arizzoni/baseboard/README.md

# baseboard
hardware audio effects I/O baseboard
