arizzoni/baseboard/doc/drd.pdf

Baseboard

Design Reference Document

(None) (None)

(None)

1

Contents

Revision History

4
1 Introduction

6
2 Specifications

6
3 System Architecture

6
4 Power Supplies

6
4.1 Overview

6
4.2 Analog Supply

7
4.2.1 Inductor

7
4.2.2 Feedback Network

8
4.2.3 Diode

. 10
4.2.4 Input/Output Capacitors

. 10
4.2.5 SEPIC Coupling Capacitor

. 10
4.2.6 Compensation Network

. 10
4.2.7 Linear Regulator

. 10
4.3 Low-Voltage Supply

. 11
4.3.1 Linear Regulator

. 11
5 Effects Interface

. 12
5.1 Switching

. 12
5.2 Interface

. 13
6 Microcontroller

. 13
6.0.1 Power

. 14
6.1 Memory

. 14
6.2 Clocks and Timing

. 14
6.3 GPIO

. 14
7 Peripherals

. 14
7.1 Overview

. 14
7.2 Footswitches

. 14
7.3 USB

. 14

Baseboard Design Reference Document | CONTENTS

This page intentionally left blank.

(None) | 3

Baseboard Design Reference Document | Revision History

Revision History

Version 1

Baseboard Design Reference Document | Revision History

This page intentionally left blank.

Baseboard Design Reference Document | Introduction

1 Introduction

The baseboard module contains all the signal and power IO for the effects pedal. Input voltage of 9V DC is regulated to 12V to drive an analog switch and the effects board and to 3.3V to drive the LED indicators and footswitches. A 16 bit microcontroller manages the switching logic, interfaces with peripherals, and supervises the power supply circuit. The audio input and output are routed to the effects modules via the switching circuitry through a cable.

2 Specifications

1. Power
(a) The Baseboard shall provide a 9–12V ±1% power supply capable of sourcing ±50 mA each to the audio effect modules
(b) The Baseboard shall provide low-voltage power circuitry capable of operation from 1.1V ±1% to 3.3V ±1%
(c) The Baseboard shall be capable of sourcing 300 mA peak to drive local peripherals
2. Input/Output
(a) The Baseboard shall route the audio signal to the baseboard while providing a true bypass path directly to the output
(b) The Baseboard shall provide input impedance of 1 MΩ ±1% and output impedance of 50 kΩ ±1%
(c) Input Filter
(d) Output Filter
3. Switching
(a) The audio signal shall be switched using high quality analog switches to maximize durability and signal integrity
(b) The switches shall have an input impedance of no greater than 500 Ω to minimize signal degradation

3 System Architecture

4 Power Supplies

4.1 Overview

Input power is provided from the DC input jack or the USB-C port and is fused with PTC thermistors. A full-bridge rectifier at the DC input jack allows for both center-negative and center-positive connections. Both supplies can be powered by either the DC input at 9–12V or the 5V USB VBUS supply, with current OR-ing capability provided by the polarity protection rectifier and a schottky diode in series with the USB VBUS. Following the current OR-ing circuitry and overcurrent protection, the input power flows to the DC/DC converters.
The Baseboard requires two voltage rails: the analog voltage rail at 12Vand the digital voltage rail at 3.3V. The analog voltage rail is powered by the Texas Instruments TPS61170 and the digital rail is powered using a voltage regulator for simplicity. The coupled-inductor SEPIC topology was selected for its low ripple and for its ability to act as both a step-up and step-down converter. The TPS61170 supports the SEPIC topology and has a high, fixed switching frequency of 1.2 MHz, allowing for small surface-mount passives to reduce cost and simplify assembly. The analog supply, at 12V, also employs a linear regulator as a filter to further reduce ripple and improve line regulation. The second regulator stage brings the voltage down to the 12V required to power the analog rail.

Baseboard Design Reference Document | 4.2 Analog Supply

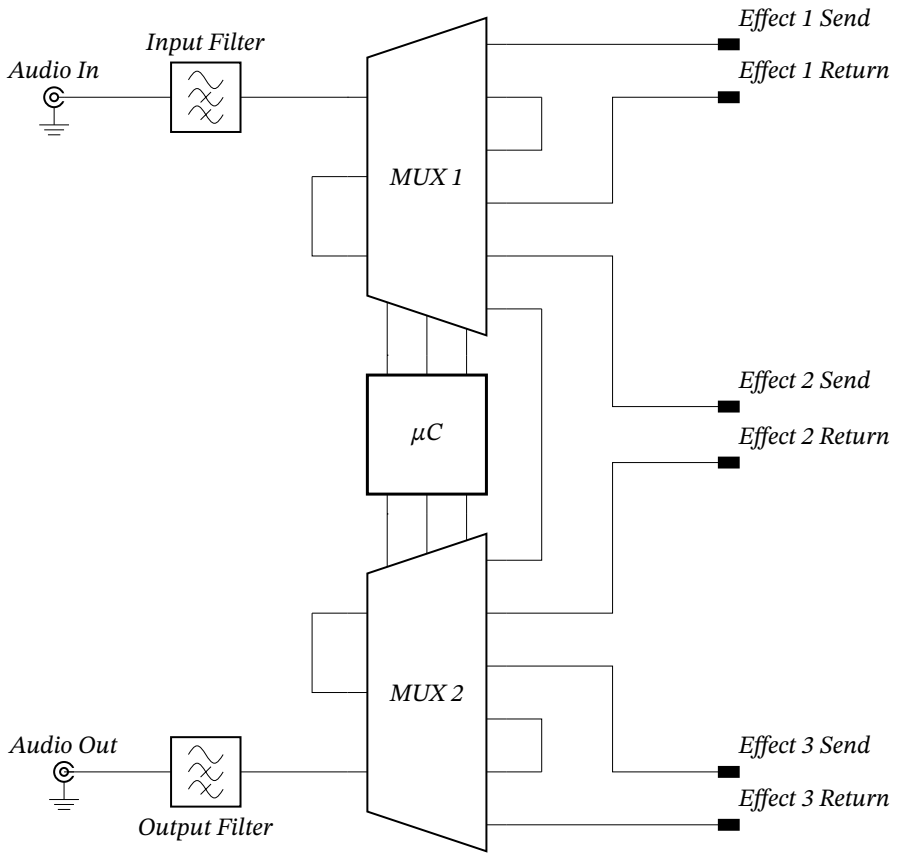
[picture p1: figure]
Audio In; Input Filter; MUX 1; Effect 1 Send; Effect 1 Return; Effect 2 Send; MUX 2; Effect 2 Return; Effect 3 Return; Effect 3 Send; Output Filter; Audio Out

Figure 1: Audio Switching Architecture

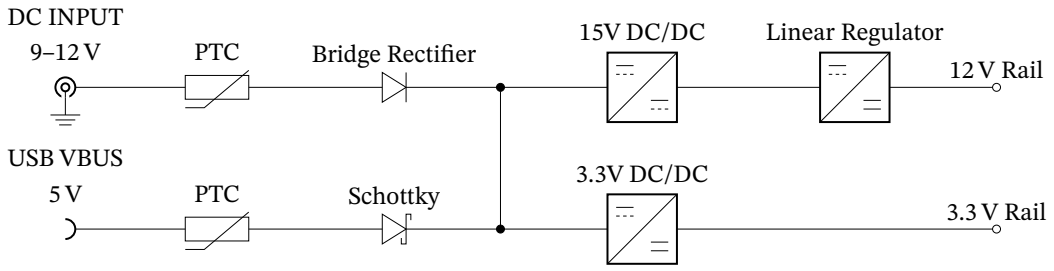
[picture p2: figure]
DC INPUT; PTC; Bridge Rectifier; Linear Regulator; 12V Rail; 3.3V Rail; USB VBUS; Schottky

Figure 2: Power Supply Architecture

4.2 Analog Supply

4.2.1 Inductor

The design for the analog DC/DC converter begins with inductor selection. Output current capacity is largely determined by the inductor size. For this design, a small inductor is sufficient as the amount of current required by the effects is generally small. A standard compact coupled inductor with series inductance of 22 µH and parallel inductance of 11 µH is predicted to be sufficient to drive loads at up to 80 mA per effects module, worst-case, by the following Monte Carlo analysis with parameters extracted from the relevant component’s datasheets

Baseboard Design Reference Document | 4.2 Analog Supply

and with three modules. The analysis was performed for the three specified input voltages: 5V, 9V, and 12V. Based on the analysis, the supply is able to safely drive 200 mA per effects module if powered from a 12V input, which allows for future expansion using this design.

300 mA | 350 mA | 400 mA | 450 mA | 500 mA

0

1000

2000 | Iout(Vin = 5V)
500 mA | 600 mA | 700 mA | 800 mA | 900 mA

0

1000

2000
Count (1)

Iout(Vin = 9V)

800 mA | 900 mA | 1 A | 1.1 A | 1.2 A | 1.3 A
Output Current (A)

0

1000

2000 | Iout(Vin12V)
300 mA | 350 mA | 400 mA | 450 mA | 500 mA

0.0

0.5

1.0
Iout(Vin = 5V)
500 mA | 600 mA | 700 mA | 800 mA | 900 mA

0.0

0.5

1.0
P (Iout ≤ Iout0

)
Iout(Vin = 9V)
800 mA | 900 mA | 1 A | 1.1 A | 1.2 A | 1.3 A
Output Current (A)

0.0

0.5

1.0
Iout(Vin12V)

Figure 3: Power Supply Maximum Output Current

The analysis begins by assuming each parameter may be described by a probability distribution function and assigning a reasonable function to each. For the majority of datasheet parameters, the manufacturer only provides three values: an upper bound, a lower bound, and a nominal value - we assume that these datasheet parameters have a triangular PDF based on the given bounds and value for the purpose of this analysis but this may very well not be the case depending on the available components.

4.2.2 Feedback Network

The output voltage of the converter is determined by the following expression.

Voᵆt = Vref (

R1
R2

+ 1)

Baseboard Design Reference Document | 4.2 Analog Supply

The output voltage is a function of R1 and R2

, and their tolerances determine the precision of the output voltage. The minimum possible output voltage, assuming all parts are within specifications, is 13.2V, so the values shall be chosen to yield an output above that so that 14V is beyond the lower tail of the output distribution. The value for Vref comes from the datasheet and is the internal feedback reference voltage of the TPS61170. The values chosen for the feedback resistors are below; a 1% tolerance was chosen as the standard design tolerance to reduce variation.

R1 = 86.6 kΩ ± 1%

R2 = 10.0 kΩ ± 1%

Voᵆt, min. ≈ 11.6V

11.7V | 11.8V | 11.9V | 12V | 12.1V
Output Voltage (V)

0

500

1000

1500

2000

Count (1)

11.7V | 11.8V | 11.9V | 12V | 12.1V
Output Voltage (V)

0.0

0.2

0.4

0.6

0.8

1.0

P (Vout ≤ Vout0

)

Figure 4: Power Supply Output Voltage

Baseboard Design Reference Document | 4.2 Analog Supply

4.2.3 Diode

The switching diode used must have a fast recovery time and support a larger reverse-voltage than that of the TPS61170 (40V). A robust component for this application is the Diodes Incorporated DFLS240L-7 in a PowerDI-123 package, which meets the requirements, has a low forward-voltage of around 20 mV at low currents, and is a standard part with many alternates available. The Diodes Incorporated DFLS260L-7, also in a PowerDI-123 package, is promoted as a robust alternate from the same family with a higher voltage rating.

ID = IS (e

qe−VD
nkBT − 1)

VD =

nkBT
qe⁻

ln (

ID
IS

+ 1)

4.2.4 Input/Output Capacitors

Input and output capacitors are selected based on the upper limits of the datasheet recommendations and are chosen to be 12 µF MLCC-type surface-mount capacitors. In order to minimize derating, a medium-voltage and physically large capacitor is selected with a voltage rating of greater than 50V.

Coᵆt,min. = 26.7 µF

4.2.5 SEPIC Coupling Capacitor

The SEPIC coupling capacitor is chosen to be 1 µF. Similar to the output capacitors, to minimize derating due to applied DC bias voltage, a medium-voltage and physically large capacitor is selected with a voltage rating of greater than 50V. The figure below suggests that a 500 nF capacitor would be sufficient, but the datasheet recommends 1 µF and there are already other 1 µF capacitors used in the design.

Cs,min. = 0.536 µF

4.2.6 Compensation Network

The compensation network for the DC/DC converter shall be tuned with the first prototypes.

4.2.7 Linear Regulator

The generic 1117-style three-terminal regulator was chosen as the post-regulator for the analog voltage rail for its low dropout voltage, low cost, and wide availability and compatibility with offerings from several manufacturers. The BOM specifies an Onsemi part number but any 1 A 1117-style regulator should be compatible.
The output voltage is determined via the typical three-terminal voltage regulator equation, shown below.

Voᵆt = Vref (1 +

R2
R1

) + IadjR2

Setting R1 = 120 Ω sets the current through the feedback network to 10 mA, which is nominally twice the required current to maintain regulation. With R1 defined, the other parameters are determined from the datasheet and a value for R2

is obtained.

Baseboard Design Reference Document | 4.3 Low-Voltage Supply
12 µF | 14 µF | 16 µF | 18 µF | 20 µF | 22 µF | 24 µF | 26 µF | 28 µF

0

5000

Cout(Vin = 5V)

10 µF | 12 µF | 14 µF | 16 µF | 18 µF | 20 µF

0

5000

Count (1)

Cout(Vin = 9V)

0 F | 200 nF | 400 nF | 600 nF | 800 nF
| | Output Capacitor Size (F)

0

250

500 | Cout(Vin12V)
12 µF | 14 µF | 16 µF | 18 µF | 20 µF | 22 µF | 24 µF | 26 µF | 28 µF

0.0

0.5

1.0
Cout(Vin = 5V)
10 µF | 12 µF | 14 µF | 16 µF | 18 µF | 20 µF

0.0

0.5

1.0

P (Cout ≤ Cout0

)

Cout(Vin = 9V)

0 F | 200 nF | 400 nF | 600 nF | 800 nF
| | Output Capacitor Size (F)

0.0

0.5

1.0
Cout(Vin12V)

Figure 5: Power Supply Output Capacitor Size

4.3 Low-Voltage Supply

4.3.1 Linear Regulator

The low voltage supply is provided by a linear voltage regulator for simplicity. In the future, a second switching converter may be designed to replace it, in the interest of efficiency. To consolidate the bill of materials the same regulator is used as for the analog supply. The output voltage is determined by the same relationship as that shown above. By letting Voᵆt = 3.3V, R1 = 120 Ω, and Iadj = 120 µA, the above relationship yields approximately R2 = 196 Ω. The low-voltage supply can be run at lower voltages. A study should be performed to determine how low - 1.8V is supported by all digital circuits in the system.

Baseboard Design Reference Document | Effects Interface
250 nF | 300 nF | 350 nF | 400 nF | 450 nF | 500 nF | 550 nF

0

5000

Cs

(Vin = 5V )

100 nF | 120 nF | 140 nF | 160 nF | 180 nF | 200 nF | 220 nF | 240 nF

0

5000

Count (1)

Cs

(Vin = 9V )

0 F | 1 nF | 2 nF | 3 nF | 4 nF | 5 nF | 6 nF | 7 nF
Coupling Capacitor Size (F)

0

250

500 | Cs

(Vin = 12V )

250 nF | 300 nF | 350 nF | 400 nF | 450 nF | 500 nF | 550 nF

0.0

0.5

1.0
Cs

(Vin = 5V )

100 nF | 120 nF | 140 nF | 160 nF | 180 nF | 200 nF | 220 nF | 240 nF

0.0

0.5

1.0
P (Cs ≤ Cs0

)
Cs

(Vin = 9V )

0 F | 1 nF | 2 nF | 3 nF | 4 nF | 5 nF | 6 nF | 7 nF
Coupling Capacitor Size (F)

0.0

0.5

1.0
Cs

(Vin = 12V )

Figure 6: Power Supply SEPIC Coupling Capacitor Size

5 Effects Interface

The effects interface connects three external effects modules through two TMUX4053 analog multiplexers. The TMUX4053 is an upgraded version of the standard 4053 CMOS multiplexer with a higher voltage rating and im-proved impedance parameters. The signals are sent to the external modules and return via the same connectors, then are routed through the multiplexer circuit to the next effects module or to the main output.

5.1 Switching

The TMUX4053 was selected for two main reasons. Primarily, it supports the 12V supply with comfortable mar-gin. As a second reason, the TMUX4053 is offered in a compact SMD package which improves reliability. The control signals for the multiplexers are generated by the RP2040 microcontroller which polls the footswitches and accordingly manages the switching logic for the multiplexers.

Baseboard Design Reference Document | 5.2 Interface
11.7V | 11.8V | 11.9V | 12V | 12.1V
Post-Regulator Output Voltage

0

500

1000

1500

2000

2500

Count (1)

Figure 7: Analog Supply Post-Regulator Output Voltage

3.24V | 3.26V | 3.28V | 3.3V | 3.32V
Digital Supply Output Voltage

0

500

1000

1500

2000

Count (1)

Vout = 12Vnom.

Figure 8: 3.3V Regulator Output Voltage

5.2 Interface

6 Microcontroller

The Raspberry Pi RP2040 dual-core ARM microcontroller was selected for two primary reasons: its extremely good cost per performance ratio despite being much more powerful than this application demands, and for the excellent documentation provided by the manufacturer.
In this design, the microcontroller performs the functions listed below, along with some other minor tasks.
- Manage audio switching logic and control analog switches
- Monitor footswitch status

Baseboard Design Reference Document | 6.1 Memory
- Control indicator LEDs
- USB 2.0 controller

6.0.1 Power

The microcontroller has a peak current draw of approximately 100 mA from the 3.3V rail, yielding a power con-sumption of approximately 330 mW. The RP2040’s internal low-voltage levels are generated using the integrated LDO which uses two external capacitors (C411 and C413), shared between pin 45 and pin 23 of the IC. The remaining external capacitors are used as decoupling capacitors for the 3.3V rail.

6.1 Memory

Any standard AT25xxx memory may be used for this design, assuming it has the correct package and memory layout. A DFN package was selected for mechanical reliability and for being widely available. The design specifies the maximum possible memory of 128 Mbit to ease the software development process, but may be reduced in the future as an exercise in cost reduction.

6.2 Clocks and Timing

The manufacturer’s recommend crystal, the ABM8-272-T3, was selected to generate the clock signals. The crystal has an SMD package and is widely available. If unavailable, a new crystal will have to be selected and rigorously tested.

6.3 GPIO

7 Peripherals

7.1 Overview

7.2 Footswitches

7.3 USB
