arizzoni/baseboard/hardware/cable-assy.dxf

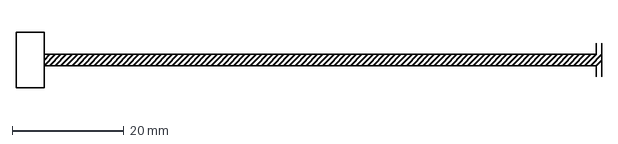
[picture p3: CAD file, 2024-08-02]
hardware/cable-assy.dxf
105.0 x 10.0 mm
