arizzoni/baseboard/hardware/enclosure/1590DD.stp

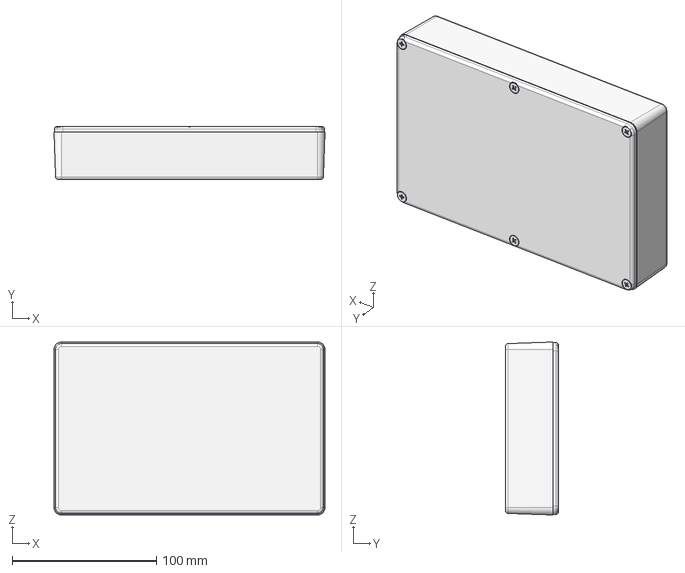
[picture p4: CAD file, 2024-08-02]
hardware/enclosure/1590DD.stp
188.0 x 37.0 x 120.0 mm
