arizzoni/baseboard/hardware/enclosure/enclosure-Template.dxf

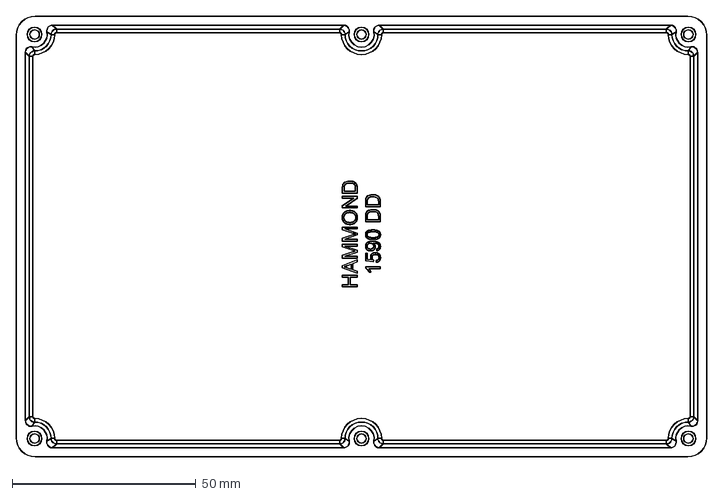
[picture p5: CAD file, 2024-08-02]
hardware/enclosure/enclosure-Template.dxf
188.0 x 120.0 mm
