arizzoni/baseboard/hardware/enclosure/enclosure-Facebinder.dxf

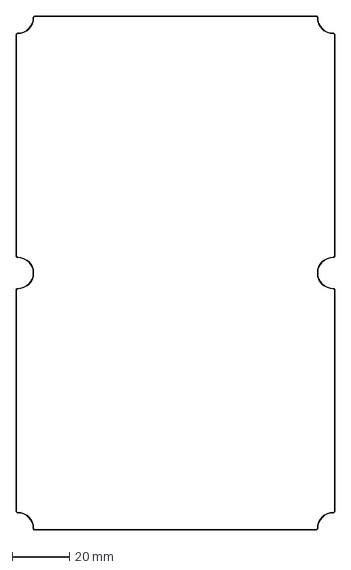
[picture p6: CAD file, 2024-08-02]
hardware/enclosure/enclosure-Facebinder.dxf
110.9 x 178.9 mm
