arizzoni/baseboard/hardware/enclosure/Unnamed1-Facebinder.dxf

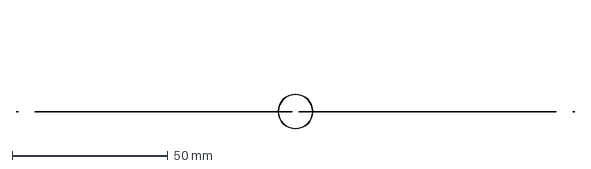
[picture p7: CAD file, 2024-08-02]
hardware/enclosure/Unnamed1-Facebinder.dxf
178.9 x 36.0 mm
