arizzoni/baseboard/hardware/enclosure/enclosure.FCStd

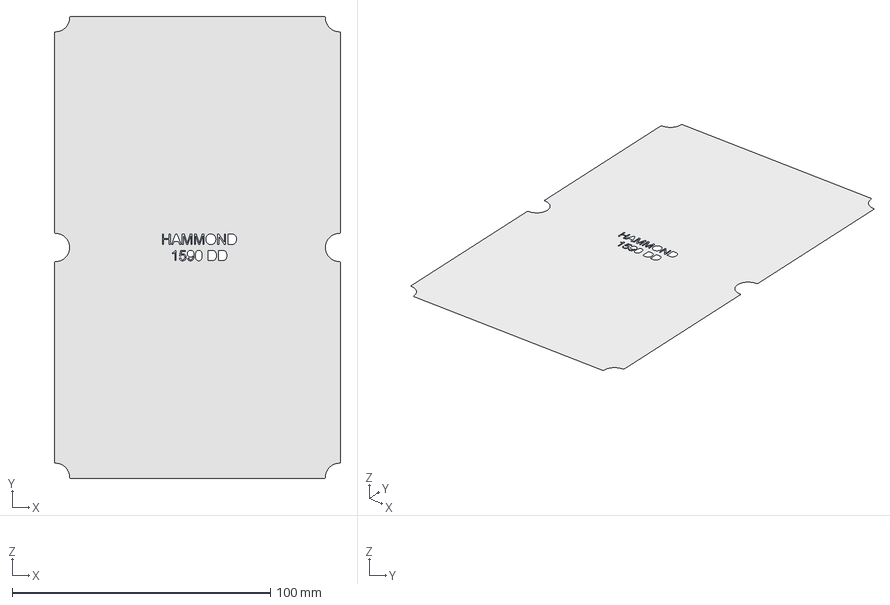
[picture p8: CAD file, 2024-08-02]
hardware/enclosure/enclosure.FCStd
110.9 x 178.9 x 9.95e-14 mm
