arizzoni/baseboard/(list of files, cad)

Other CAD files:
hardware/enclosure/enclosure-Page.dxf
hardware/enclosure/1590DD.igs
