arizzoni/baseboard/doc/todo.md

#TODO
1.  SEPIC Converter compensation + control loop modeling
2.  EMI Analysis
3.  Power Tree/Power Consumption Analysis
4.  Switching + Filtering Impedance/Attenuation Analysis
