arizzoni/baseboard/hardware/baseboard.pdf

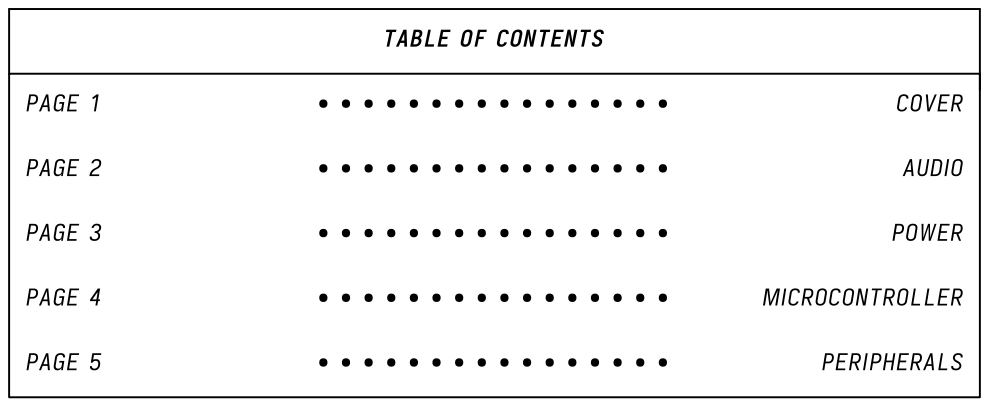
[picture p9: page 1]

þÿ "þÿ "þÿ "þÿ "þÿ "þÿ "þÿ "þÿ "þÿ "þÿ "þÿ "þÿ "þÿ "þÿ "þÿ "þÿ " TABLEOF CONTENTS

4: PCBLAYOUTACCORDINGTO DATASHEETFORALL COMPONENTS
3: ALL CAPACITORSMLCC, X7R ORX7S DIELECTRIC,10% TOLERANCEORSMALLER
2: ALL RESISTORSLOWNOISETHIN FILM, 1% TOLERANCEORSMALLER, 1/10W RATINGORGREATER
1: ALL COMPONENTS25V RATINGORGREATER

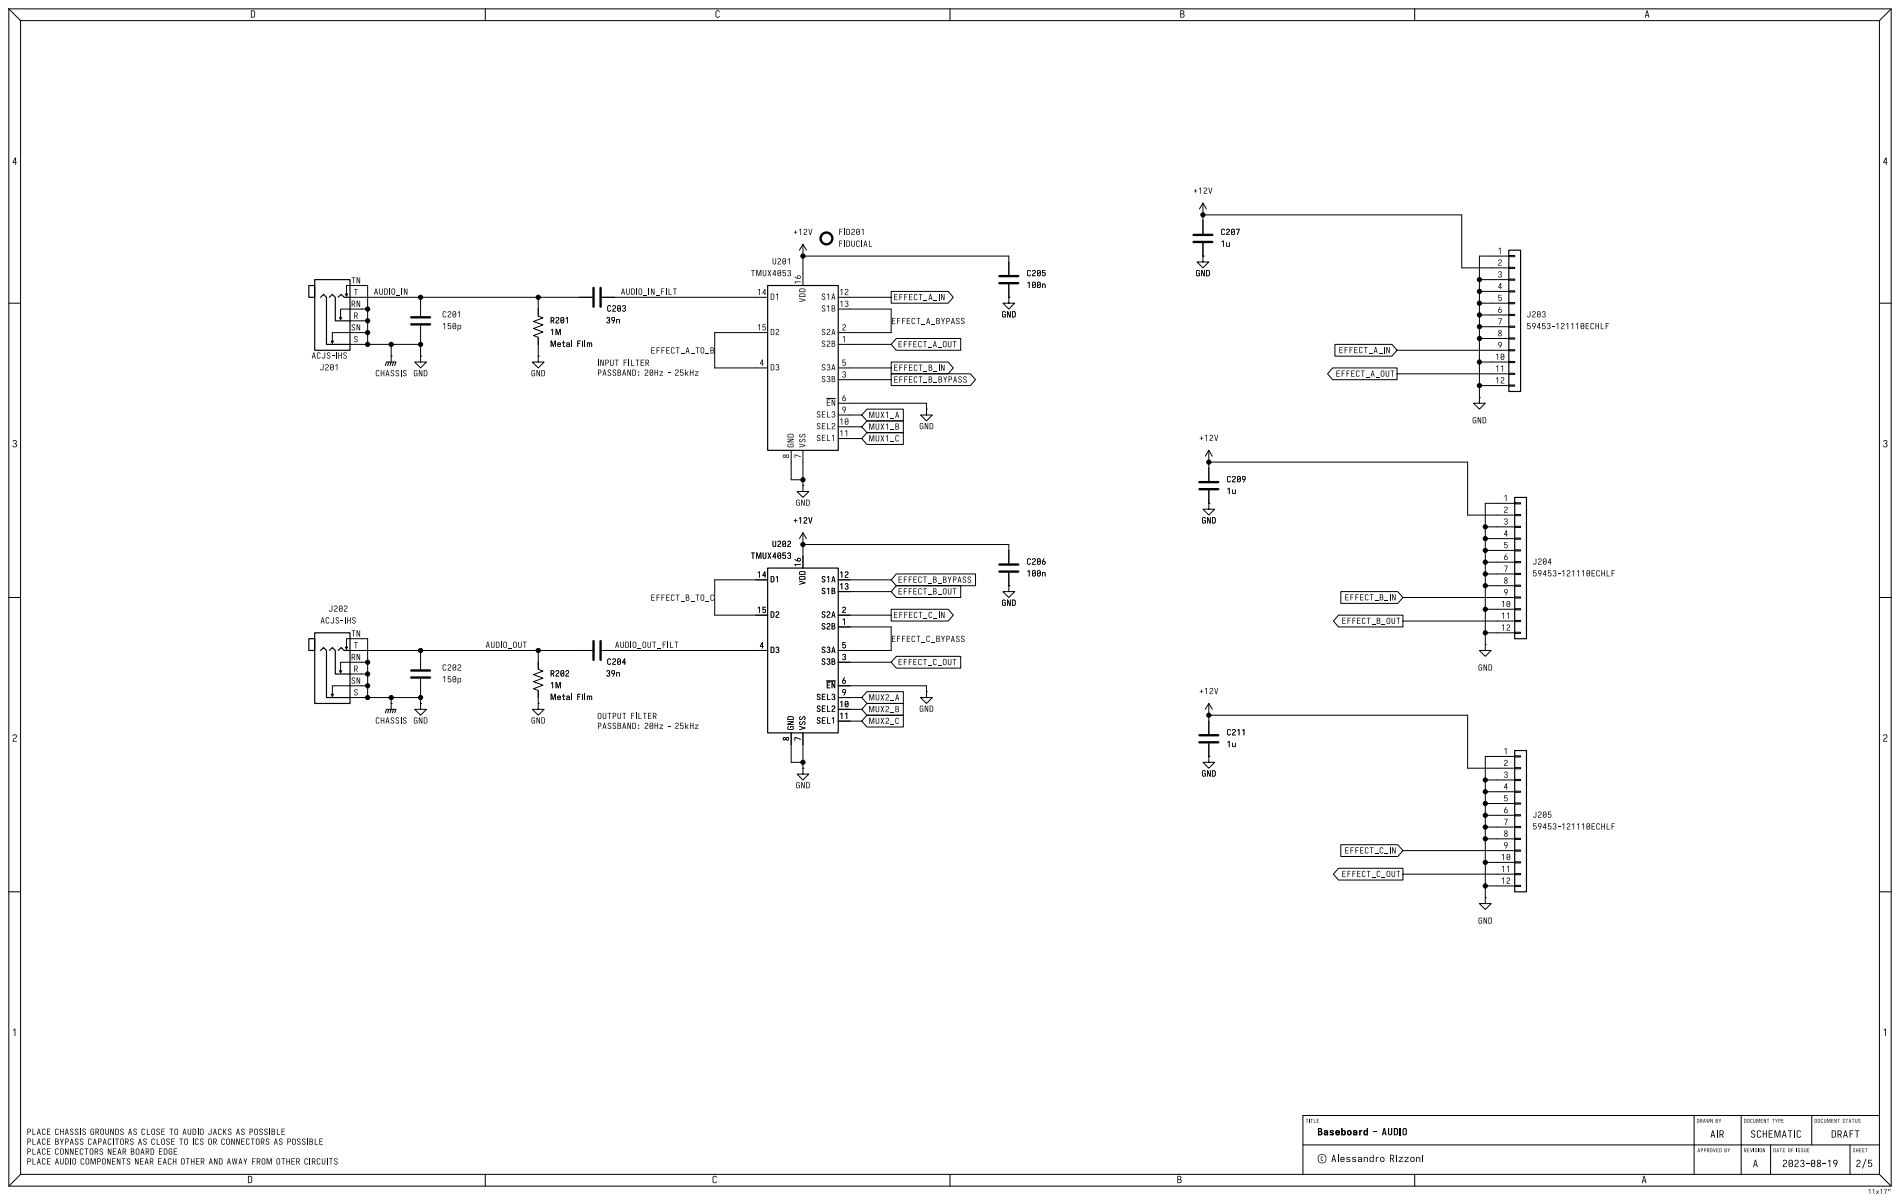
[picture p10: page 2]

PASSBAND:20Hz - 25kHz PLACECHASSISGROUNDSAS CLOSETO AUDIOJACKS AS POSSIBLE

PLACEBYPASSCAPACITORSAS CLOSETO ICS ORCONNECTORSAS POSSIBLE
PLACECONNECTORSNEARBOARDEDGE
PLACEAUDIOCOMPONENTSNEAREACHOTHERANDAWAYFROMOTHERCIRCUITS

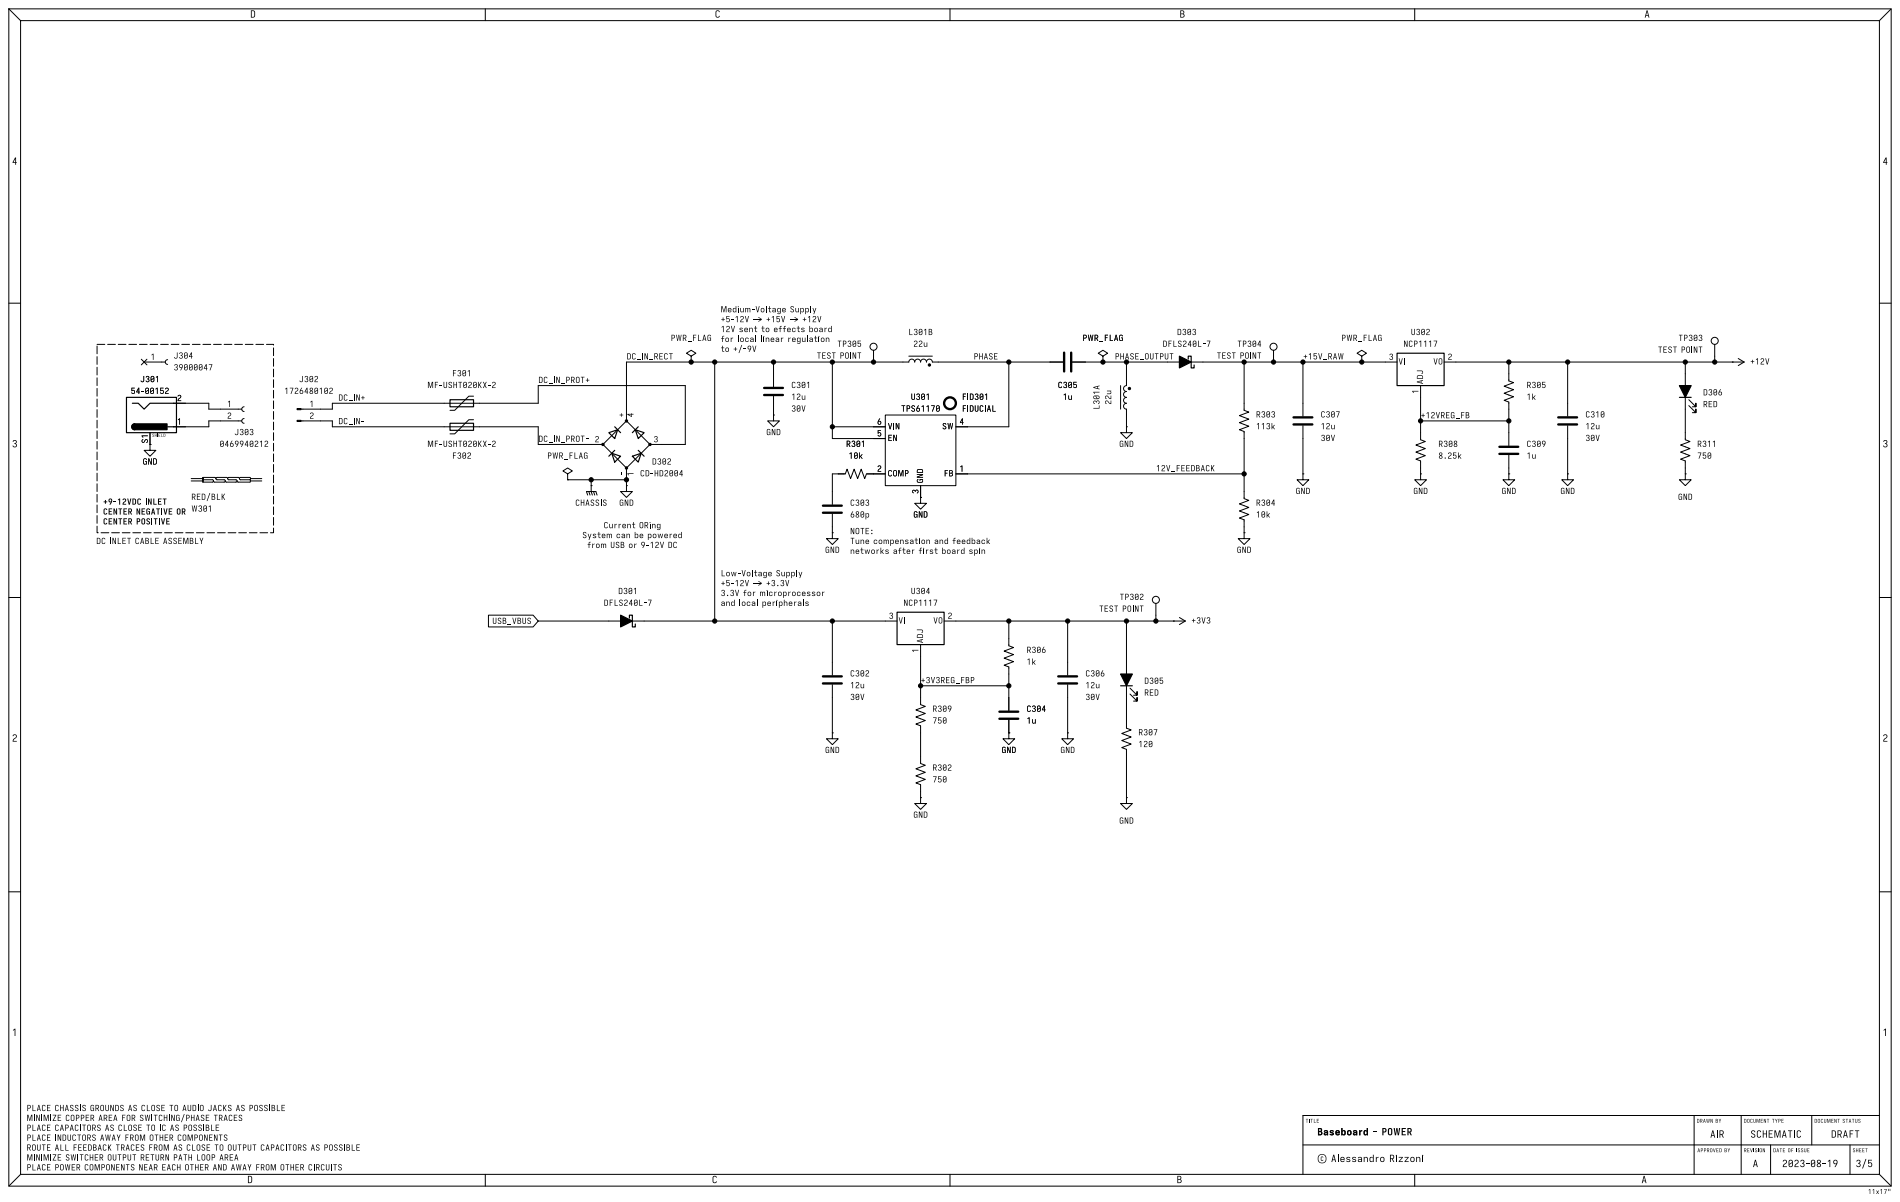
[picture p11: page 3]

12V sent to effects board
for local linear regulation

3.3V for microprocessor and local peripherals Current ORing
System can be powered

PLACECHASSISGROUNDSAS CLOSETO AUDIOJACKS AS POSSIBLE MINIMIZE COPPERAREAFORSWITCHING/PHASETRACES

PLACECAPACITORSAS CLOSETO IC AS POSSIBLE
PLACEINDUCTORSAWAYFROMOTHERCOMPONENTS ROUTEALL FEEDBACKTRACESFROMAS CLOSETO OUTPUTCAPACITORSAS POSSIBLE MINIMIZE SWITCHEROUTPUTRETURNPATH LOOPAREA

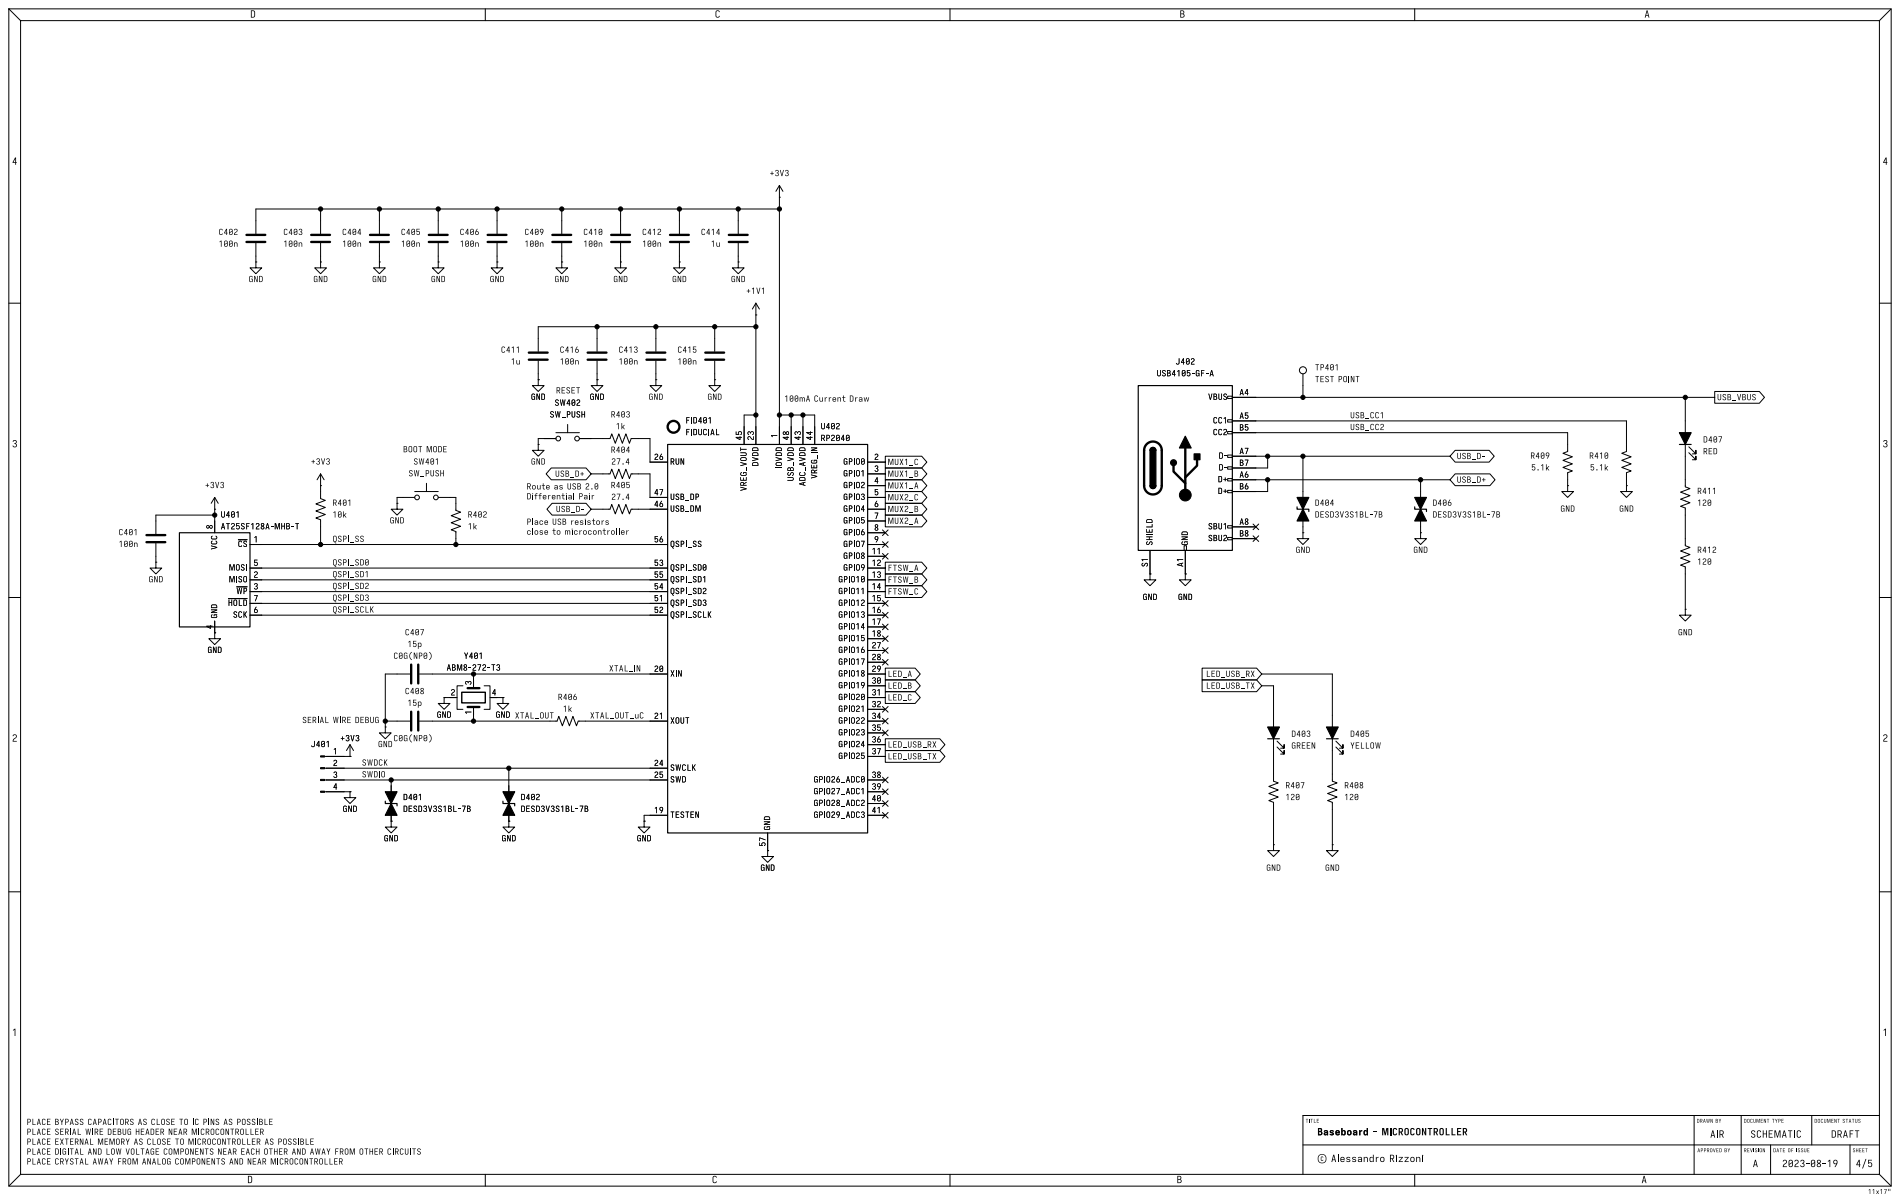
[picture p12: page 4]

8 FID401 FIDUCIAL SW402 SW_PUSH GND GND GND GND

PLACEBYPASSCAPACITORSAS CLOSETO IC PINS AS POSSIBLE
PLACESERIAL WIREDEBUGHEADERNEARMICROCONTROLLER
PLACEEXTERNALMEMORYAS CLOSETO MICROCONTROLLERAS POSSIBLE
PLACEDIGITALANDLOWVOLTAGECOMPONENTSNEAREACHOTHERANDAWAYFROMOTHERCIRCUITS
PLACECRYSTALAWAYFROMANALOGCOMPONENTSANDNEARMICROCONTROLLER

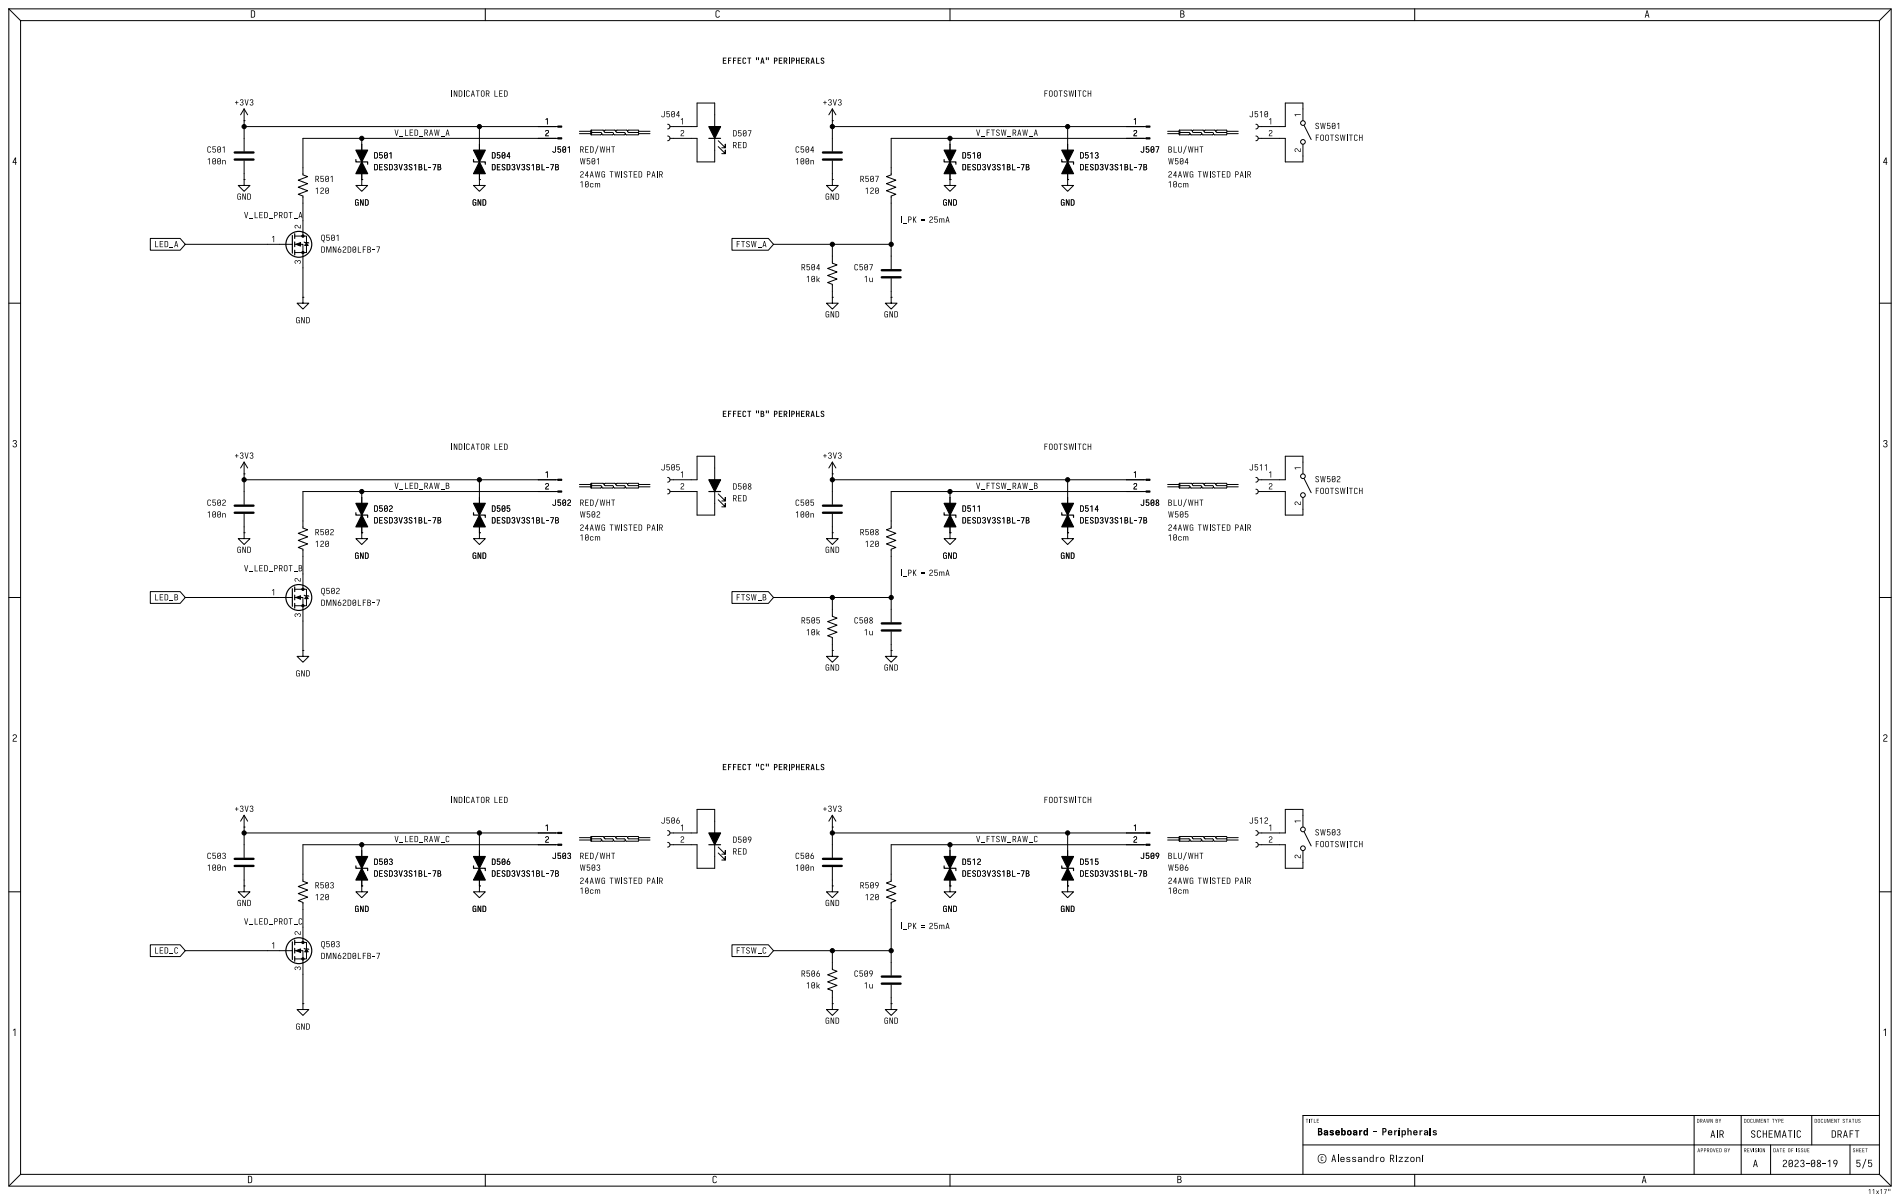
[picture p13: page 5]
