arizzoni/baseboard/hardware/sim/peripheral-switches/sim.kicad_pcb

## KiCad design ADC.kicad_sch

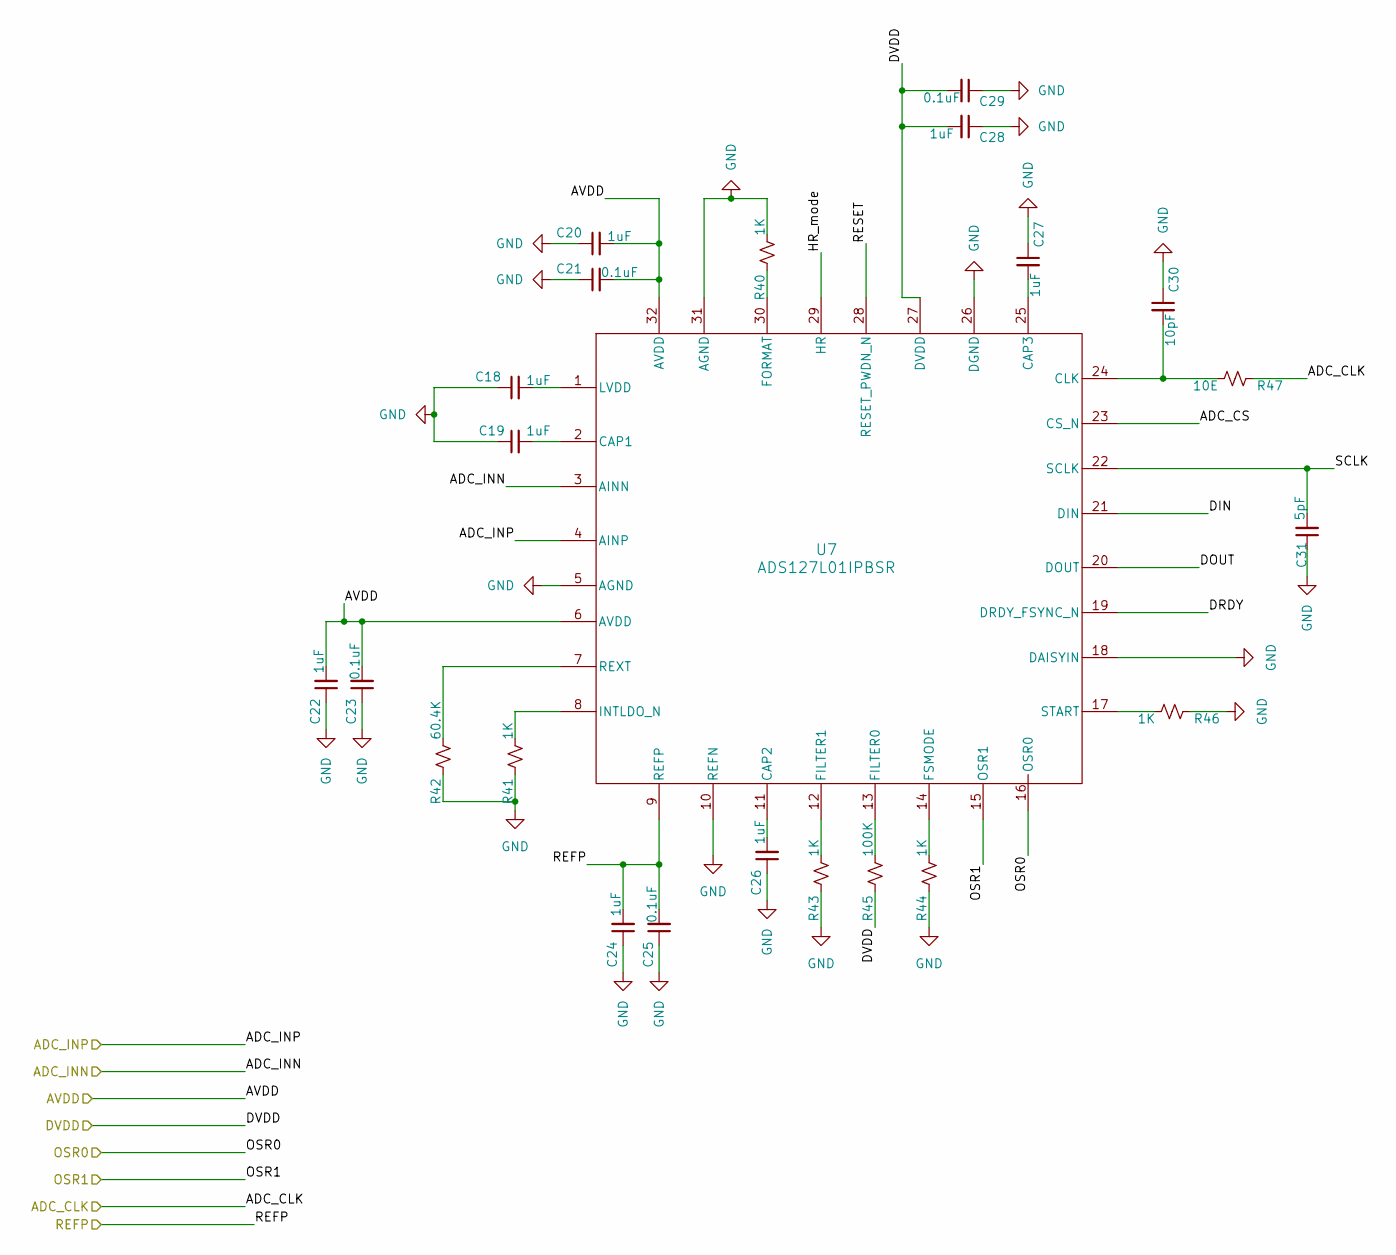
[picture p14: schematic ADC.kicad_sch]

Parts:
C18, C19, C20, C22, C24, C26, C27, C28: 1uF
C21, C23, C25, C29: 0.1uF
C30: 10pF
C31: 5pF
R40, R41, R43, R44, R46: 1K
R42: 60.4K
R45: 100K
R47: 10E
U7: ADS127L01IPBSR; PBS0032A_N

Connections:
ADC_CLK: R47.2
ADC_CS: U7.23 (CS_N)
ADC_INN: U7.3 (AINN)
ADC_INP: U7.4 (AINP)
AVDD: C20.2, C21.2, C22.2, C23.2, U7.6 (AVDD), U7.32 (AVDD)
DIN: U7.21 (DIN)
DOUT: U7.20 (DOUT)
DRDY: U7.19 (DRDY_FSYNC_N)
DVDD: C28.2, C29.2, R45.2, U7.27 (DVDD)
GND: C18.1, C19.1, C20.1, C21.1, C22.1, C23.1, C24.1, C25.1, C26.1, C27.1, C28.1, C29.1, C30.1, C31.1, R40.1, R41.2, R42.2, R43.2, R44.2, R46.2, U7.5 (AGND), U7.10 (REFN), U7.18 (DAISYIN), U7.26 (DGND), U7.31 (AGND)
HR_mode: U7.29 (HR)
unnamed: C18.2, U7.1 (LVDD)
unnamed: C19.2, U7.2 (CAP1)
unnamed: C26.2, U7.11 (CAP2)
unnamed: C27.2, U7.25 (CAP3)
unnamed: C30.2, R47.1, U7.24 (CLK)
unnamed: R40.2, U7.30 (FORMAT)
unnamed: R41.1, U7.8 (INTLDO_N)
unnamed: R42.1, U7.7 (REXT)
unnamed: R43.1, U7.12 (FILTER1)
unnamed: R44.1, U7.14 (FSMODE)
unnamed: R45.1, U7.13 (FILTER0)
unnamed: R46.1, U7.17 (START)
OSR0: U7.16 (OSR0)
OSR1: U7.15 (OSR1)
REFP: C24.2, C25.2, U7.9 (REFP)
RESET: U7.28 (RESET_PWDN_N)
SCLK: C31.2, U7.22 (SCLK)
