arizzoni/baseboard/hardware/sim/peripheral-switches/sim.kicad_pcb

## KiCad design Bias Current.kicad_sch

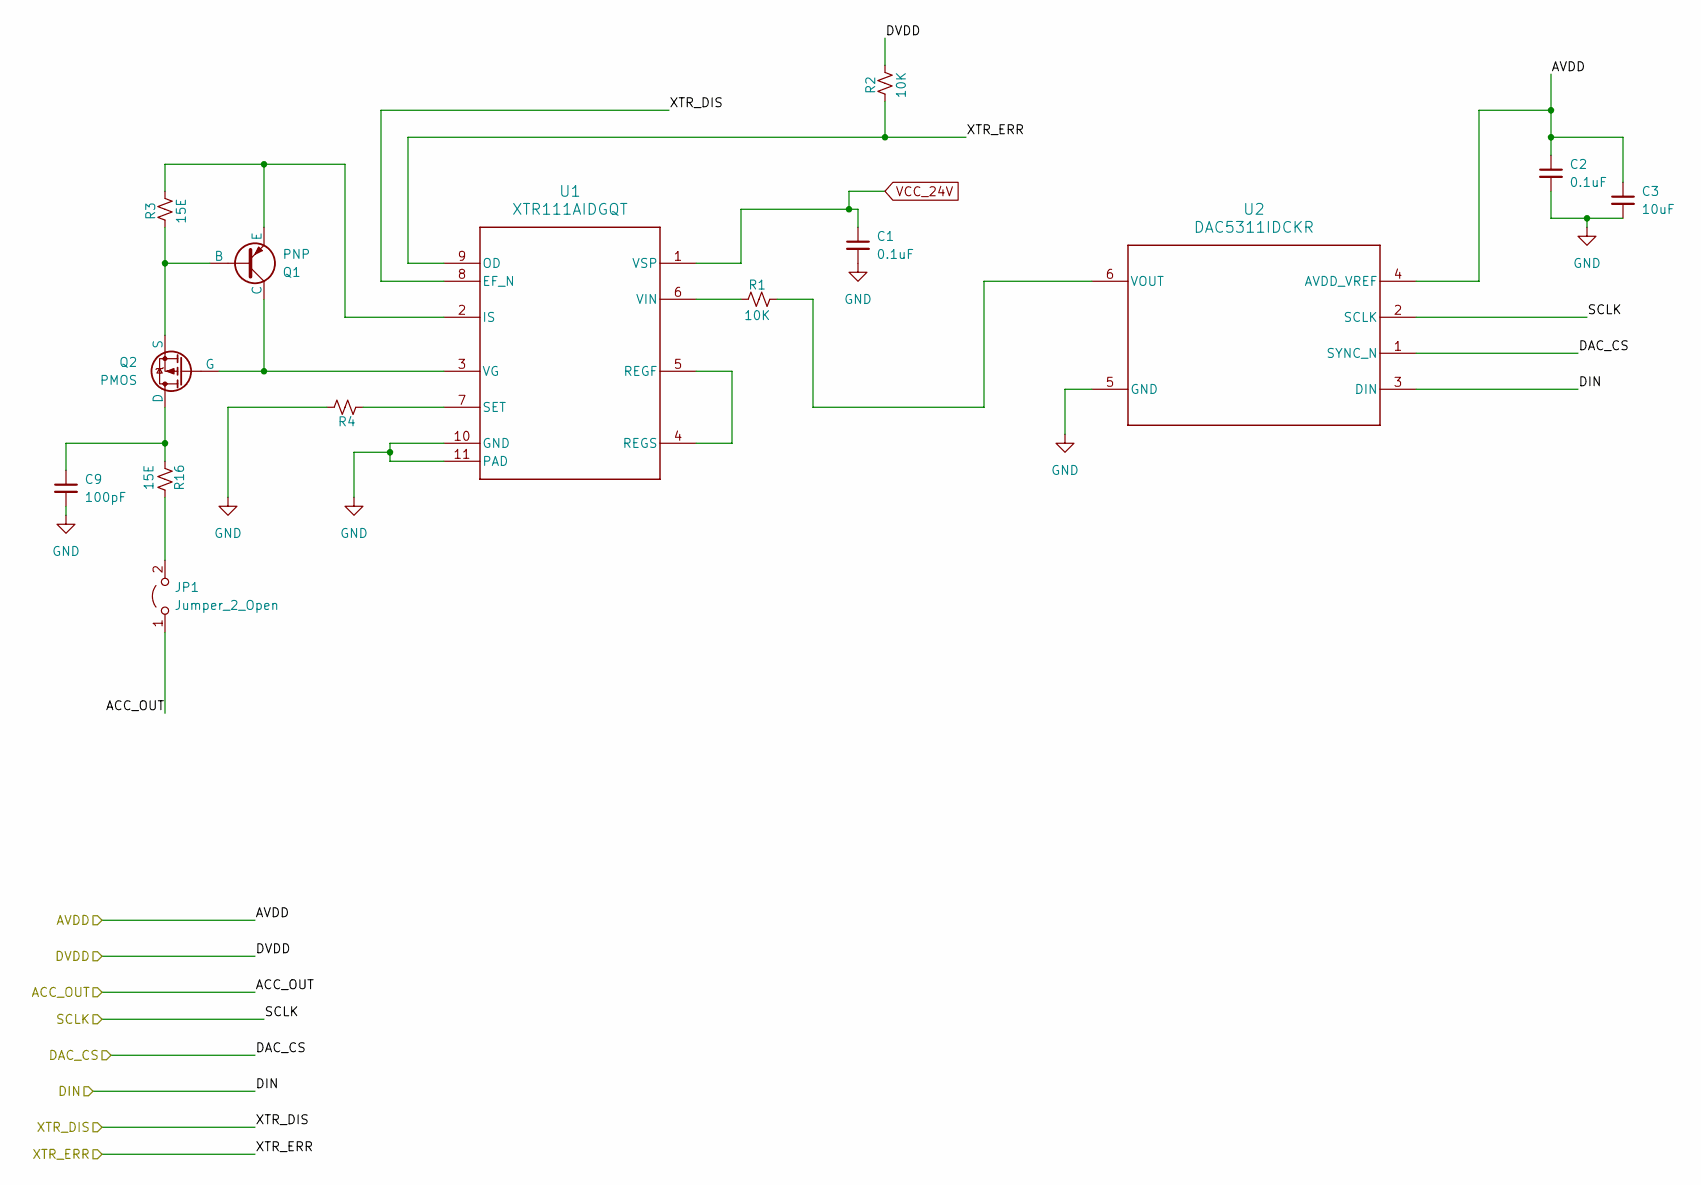
[picture p15: schematic Bias Current.kicad_sch]

Parts:
C1, C2: 0.1uF
C3: 10uF
C9: 100pF
JP1: Jumper_2_Open
Q1: PNP
Q2: PMOS
R1, R2: 10K
R3, R16: 15E
R4: (no value)
U1: XTR111AIDGQT; DGQ0010D_NV_N
U2: DAC5311IDCKR; DCK0006A_N

Connections:
ACC_OUT: JP1.1 (A)
AVDD: C2.1, C3.1, U2.4 (AVDD_VREF)
DAC_CS: U2.1 (SYNC_N)
DIN: U2.3 (DIN)
DVDD: R2.2
GND: C1.2, C2.2, C3.2, C9.2, R4.2, U1.10 (GND), U1.11 (PAD), U2.5 (GND)
unnamed: C9.1, Q2.1 (D), R16.1
unnamed: JP1.2 (B), R16.2
unnamed: Q1.1 (C), Q2.2 (G), U1.3 (VG)
unnamed: Q1.2 (B), Q2.3 (S), R3.1
unnamed: Q1.3 (E), R3.2, U1.2 (IS)
unnamed: R1.1, U1.6 (VIN)
unnamed: R1.2, U2.6 (VOUT)
unnamed: R4.1, U1.7 (SET)
unnamed: U1.4 (REGS), U1.5 (REGF)
SCLK: U2.2 (SCLK)
VCC_24V: C1.1, U1.1 (VSP)
XTR_DIS: U1.8 (EF_N)
XTR_ERR: R2.1, U1.9 (OD)
