arizzoni/baseboard/hardware/sim/peripheral-switches/sim.kicad_pcb

## KiCad design CMOS_Tristate_Oscillator.kicad_sch

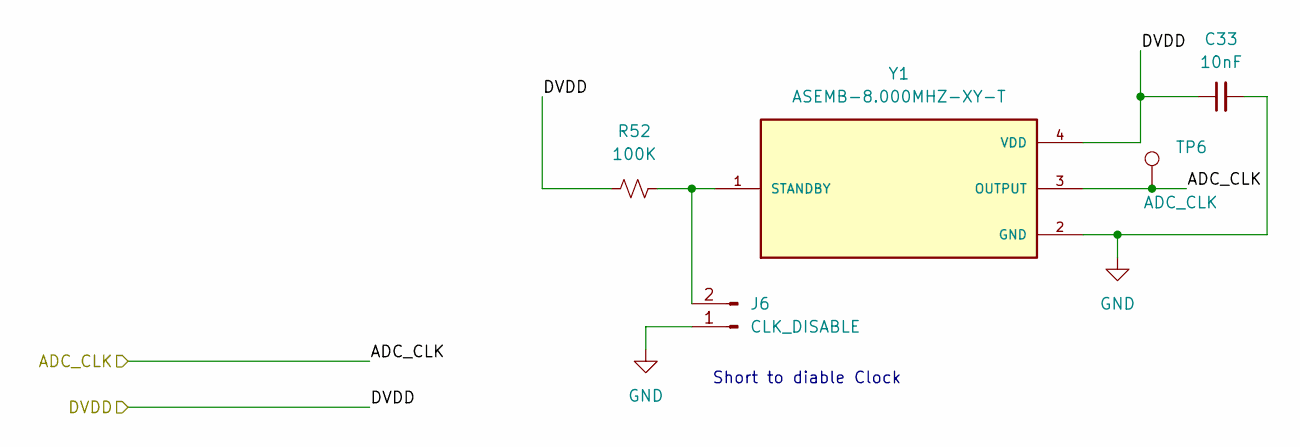
[picture p16: schematic CMOS_Tristate_Oscillator.kicad_sch]

Parts:
C33: 10nF
J6: CLK_DISABLE
R52: 100K
TP6: ADC_CLK
Y1: ASEMB-8.000MHZ-XY-T; XTAL_ASEMB-8.000MHZ-XY-T; PARTREV 1.4.2021

Connections:
ADC_CLK: TP6.1, Y1.3 (OUTPUT)
DVDD: C33.1, R52.1, Y1.4 (VDD)
GND: C33.2, J6.1, Y1.2 (GND)
unnamed: J6.2, R52.2, Y1.1 (STANDBY)

Notes on the sheet:
Short to diable Clock
