arizzoni/baseboard/hardware/sim/peripheral-switches/sim.kicad_pcb

## KiCad design Common Mode Voltage.kicad_sch

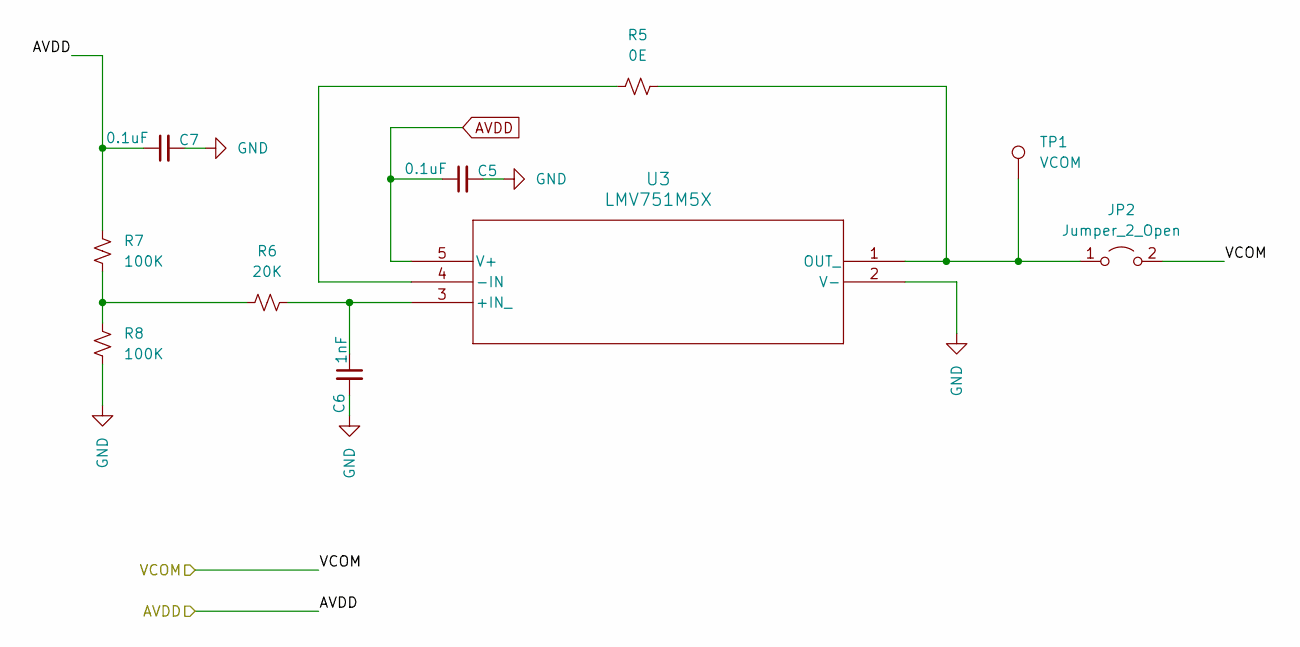
[picture p17: schematic Common Mode Voltage.kicad_sch]

Parts:
C5, C7: 0.1uF
C6: 1nF
JP2: Jumper_2_Open
R5: 0E
R6: 20K
R7, R8: 100K
TP1: VCOM
U3: LMV751M5X; MF05A_TEX

Connections:
AVDD: C5.1, C7.1, R7.2, U3.5 (V+)
GND: C5.2, C6.2, C7.2, R8.1, U3.2 (V-)
unnamed: C6.1, R6.2, U3.3 (+IN_)
unnamed: JP2.1 (A), R5.2, TP1.1, U3.1 (OUT_)
unnamed: R5.1, U3.4 (-IN)
unnamed: R6.1, R7.1, R8.2
VCOM: JP2.2 (B)
