arizzoni/baseboard/hardware/sim/peripheral-switches/sim.kicad_pcb

## KiCad design DC bias and att.kicad_sch

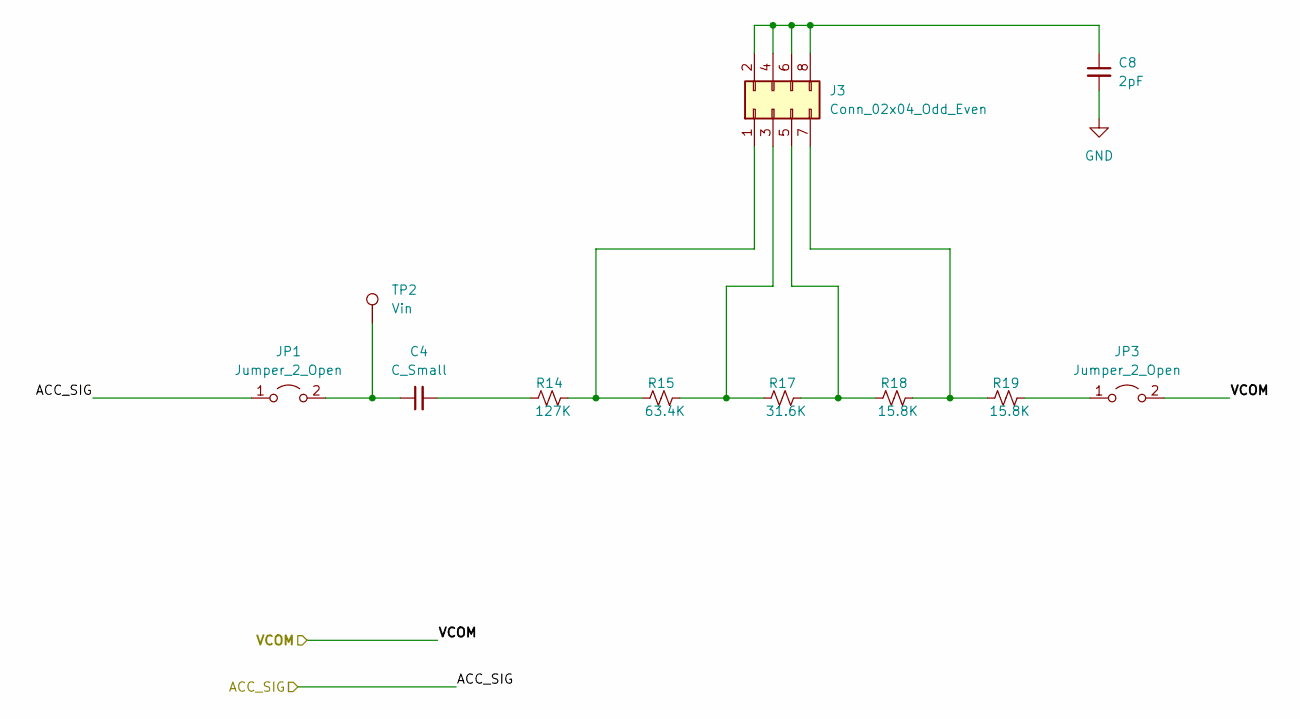
[picture p18: schematic DC bias and att.kicad_sch]

Parts:
C4: C_Small
C8: 2pF
J3: Conn_02x04_Odd_Even
JP1, JP3: Jumper_2_Open
R14: 127K
R15: 63.4K
R17: 31.6K
R18, R19: 15.8K
TP2: Vin

Connections:
ACC_SIG: JP1.1 (A)
GND: C8.2
unnamed: C4.1, JP1.2 (B), TP2.1
unnamed: C4.2, R14.1
unnamed: C8.1, J3.2, J3.4, J3.6, J3.8
unnamed: J3.1, R14.2, R15.1
unnamed: J3.3, R15.2, R17.1
unnamed: J3.5, R17.2, R18.1
unnamed: J3.7, R18.2, R19.1
unnamed: JP3.1 (A), R19.2
VCOM: JP3.2 (B)
