arizzoni/baseboard/hardware/sim/peripheral-switches/sim.kicad_pcb

## KiCad design DC bias ant att.kicad_sch

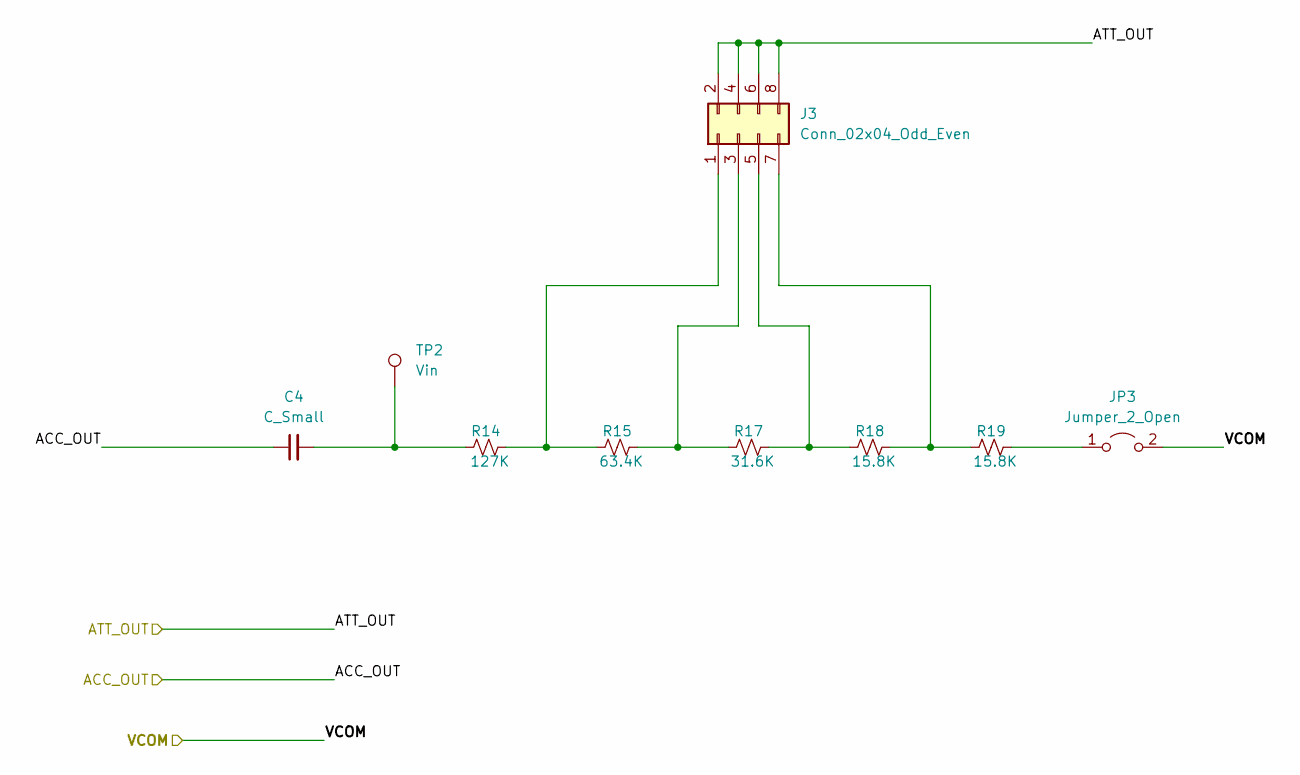
[picture p19: schematic DC bias ant att.kicad_sch]

Parts:
C4: C_Small
J3: Conn_02x04_Odd_Even
JP3: Jumper_2_Open
R14: 127K
R15: 63.4K
R17: 31.6K
R18, R19: 15.8K
TP2: Vin

Connections:
ACC_OUT: C4.1
ATT_OUT: J3.2, J3.4, J3.6, J3.8
unnamed: C4.2, R14.1, TP2.1
unnamed: J3.1, R14.2, R15.1
unnamed: J3.3, R15.2, R17.1
unnamed: J3.5, R17.2, R18.1
unnamed: J3.7, R18.2, R19.1
unnamed: JP3.1 (A), R19.2
VCOM: JP3.2 (B)
