arizzoni/baseboard/hardware/sim/peripheral-switches/sim.kicad_pcb

## KiCad design Differential ADC driver.kicad_sch

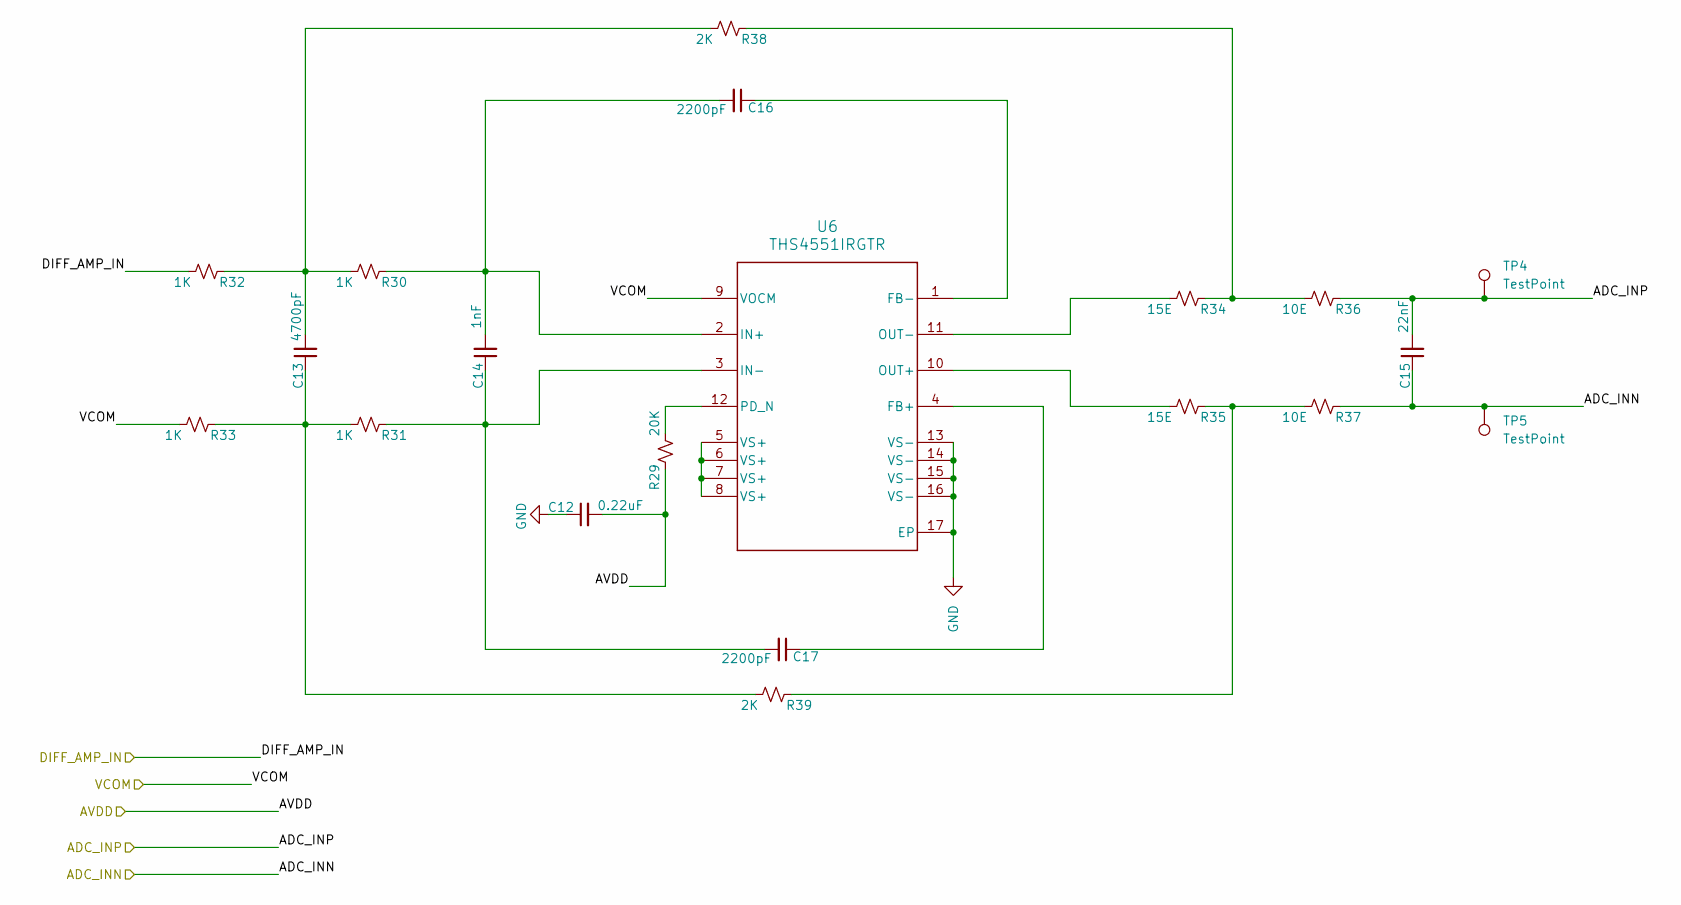
[picture p20: schematic Differential ADC driver.kicad_sch]

Parts:
C12: 0.22uF
C13: 4700pF
C14: 1nF
C15: 22nF
C16, C17: 2200pF
R29: 20K
R30, R31, R32, R33: 1K
R34, R35: 15E
R36, R37: 10E
R38, R39: 2K
TP4, TP5: TestPoint
U6: THS4551IRGTR; RGT0016C

Connections:
ADC_INN: C15.1, R37.2, TP5.1
ADC_INP: C15.2, R36.2, TP4.1
AVDD: C12.2, R29.2
DIFF_AMP_IN: R32.1
GND: C12.1, U6.13 (VS-), U6.14 (VS-), U6.15 (VS-), U6.16 (VS-), U6.17 (EP)
unnamed: C13.1, R31.1, R33.2, R39.1
unnamed: C13.2, R30.1, R32.2, R38.1
unnamed: C14.1, C17.2, R31.2, U6.3 (IN-)
unnamed: C14.2, C16.2, R30.2, U6.2 (IN+)
unnamed: C16.1, U6.1 (FB-)
unnamed: C17.1, U6.4 (FB+)
unnamed: R29.1, U6.12 (PD_N)
unnamed: R34.1, U6.11 (OUT-)
unnamed: R34.2, R36.1, R38.2
unnamed: R35.1, U6.10 (OUT+)
unnamed: R35.2, R37.1, R39.2
unnamed: U6.5 (VS+), U6.6 (VS+), U6.7 (VS+), U6.8 (VS+)
VCOM: R33.1, U6.9 (VOCM)
