arizzoni/baseboard/hardware/sim/peripheral-switches/sim.kicad_pcb

## KiCad design IEPE Texas Instruments TIDUD62 Receiver.kicad_sch

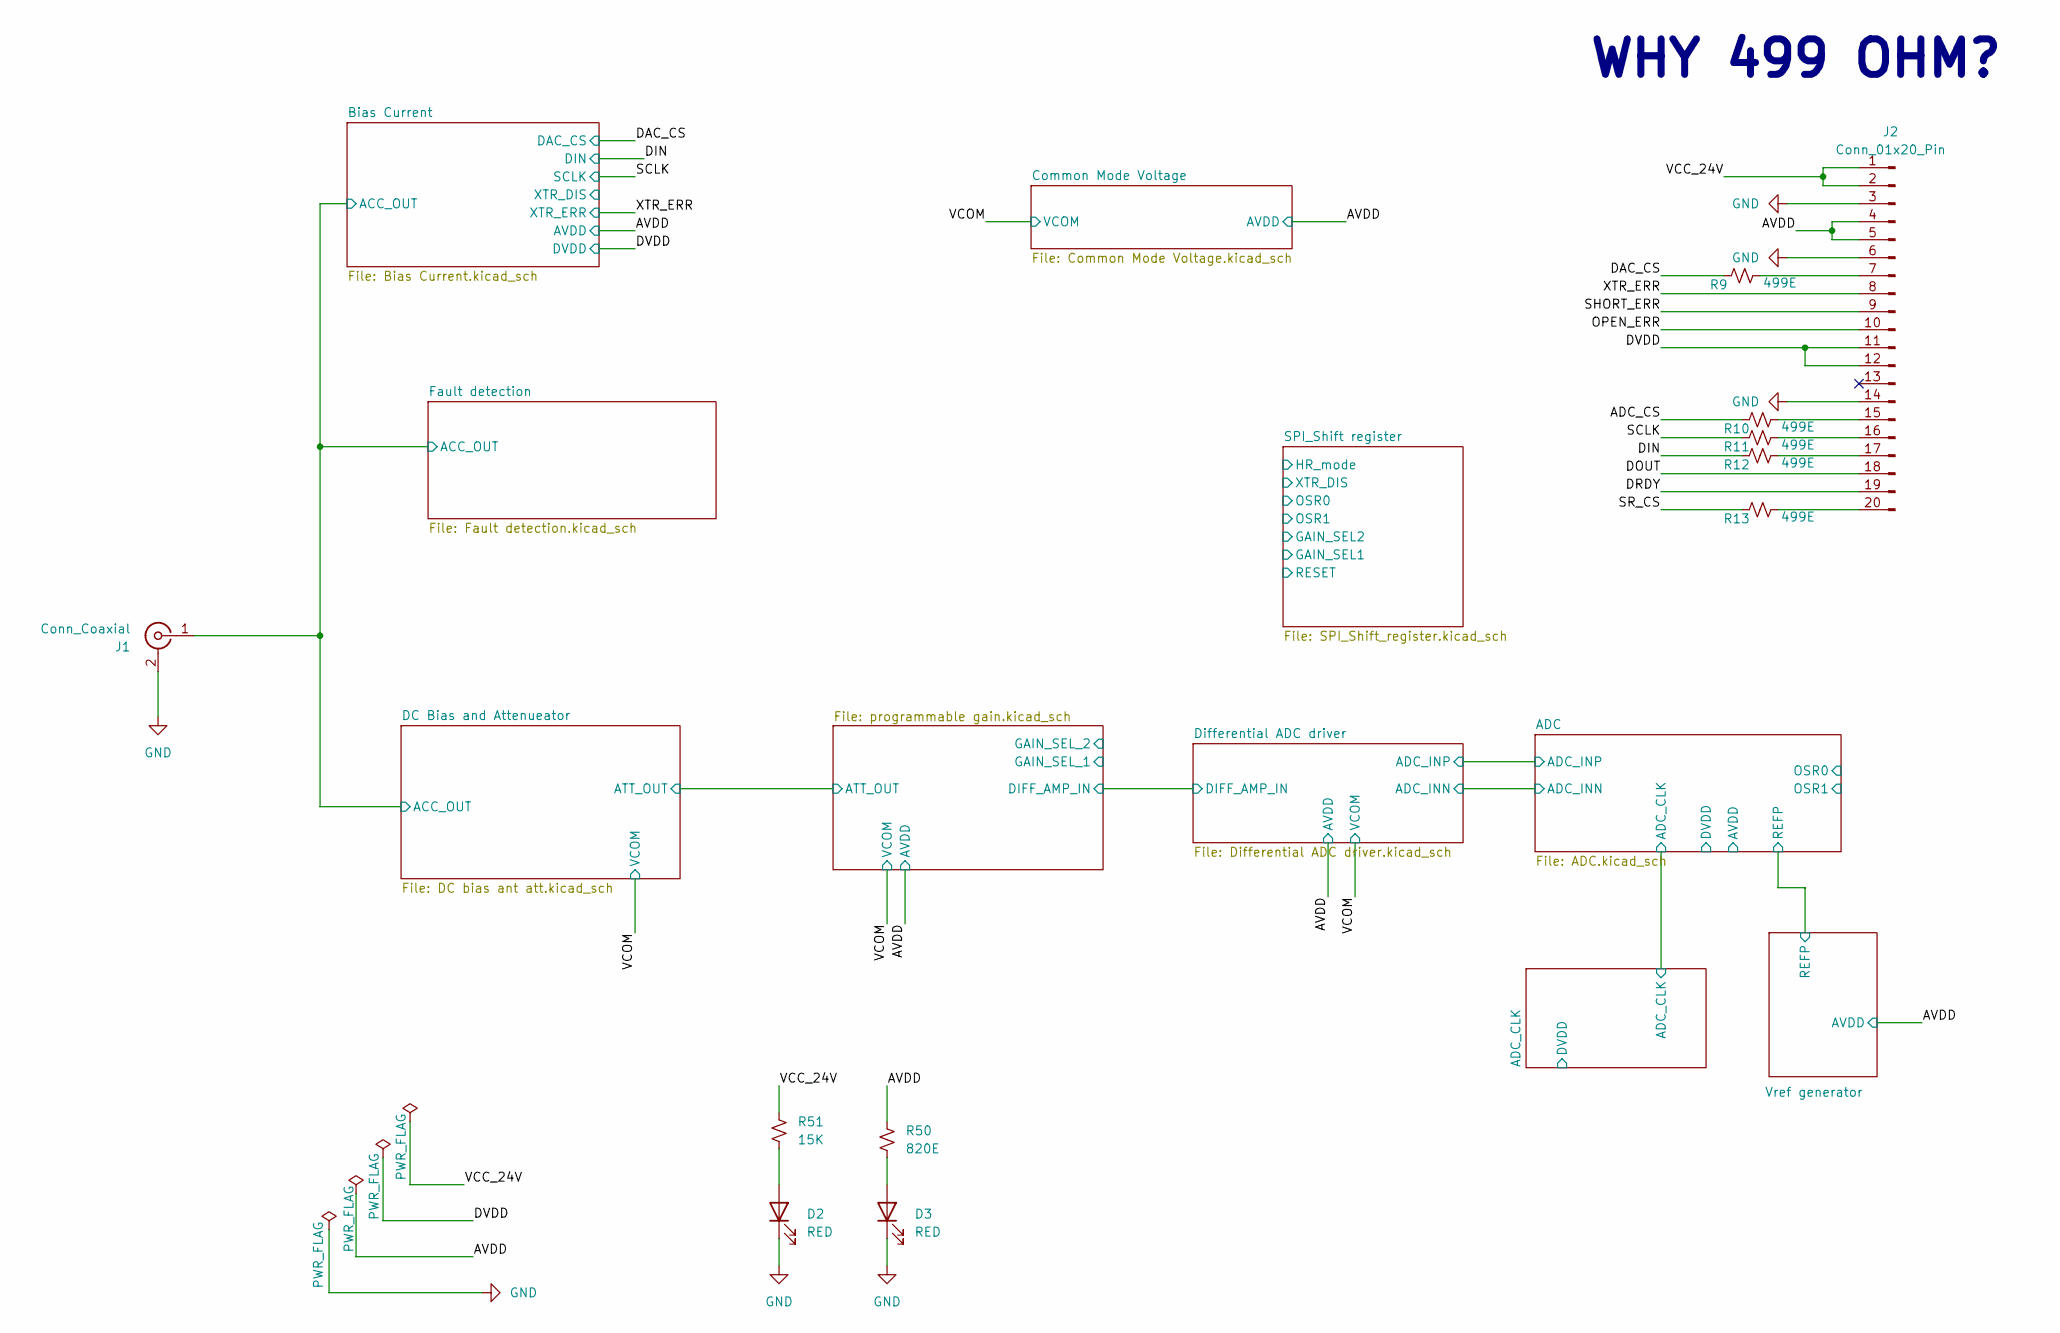
[picture p21: schematic IEPE Texas Instruments TIDUD62 Receiver.kicad_sch]

Parts:
D2, D3: RED
J1: Conn_Coaxial
J2: Conn_01x20_Pin
R9, R10, R11, R12, R13: 499E
R50: 820E
R51: 15K

Connections:
ACC_OUT: J1.1 (In)
ADC_CS: R10.1
AVDD: J2.4, J2.5, R50.1
DAC_CS: R9.1
DIN: R12.1
DOUT: J2.18
DRDY: J2.19
DVDD: J2.11, J2.12
GND: D2.1 (K), D3.1 (K), J1.2 (Ext), J2.3, J2.6, J2.14
unnamed: D2.2 (A), R51.2
unnamed: D3.2 (A), R50.2
unnamed: J2.7, R9.2
unnamed: J2.15, R10.2
unnamed: J2.16, R11.2
unnamed: J2.17, R12.2
unnamed: J2.20, R13.2
OPEN_ERR: J2.10
SCLK: R11.1
SHORT_ERR: J2.9
SR_CS: R13.1
VCC_24V: J2.1, J2.2, R51.1
XTR_ERR: J2.8

Notes on the sheet:
WHY 499 OHM?
