arizzoni/baseboard/hardware/sim/peripheral-switches/sim.kicad_pcb

## KiCad design SPI_Shift_register.kicad_sch

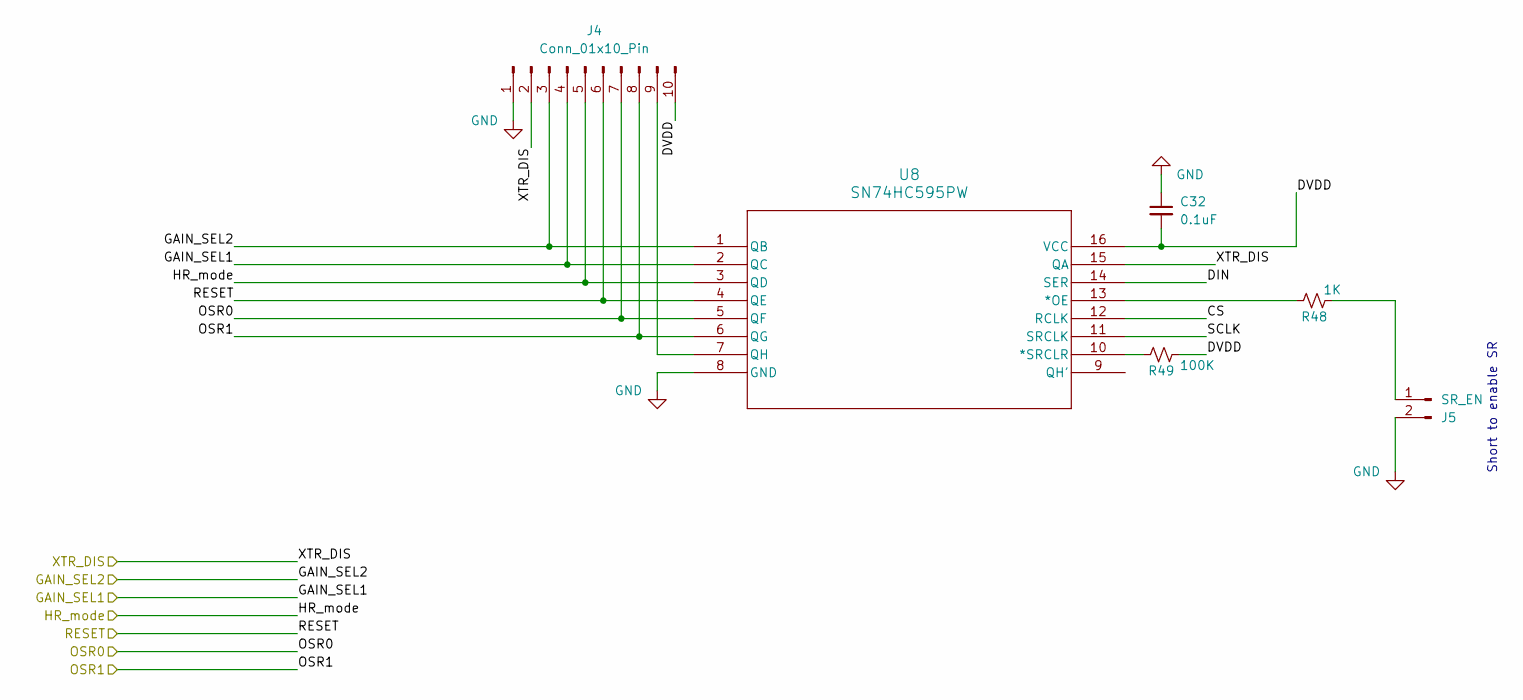
[picture p22: schematic SPI_Shift_register.kicad_sch]

Parts:
C32: 0.1uF
J4: Conn_01x10_Pin
J5: SR_EN
R48: 1K
R49: 100K
U8: SN74HC595PW; PW16

Connections:
CS: U8.12 (RCLK)
DIN: U8.14 (SER)
DVDD: C32.2, J4.10, R49.2, U8.16 (VCC)
GAIN_SEL1: J4.4, U8.2 (QC)
GAIN_SEL2: J4.3, U8.1 (QB)
GND: C32.1, J4.1, J5.2, U8.8 (GND)
HR_mode: J4.5, U8.3 (QD)
unnamed: J4.9, U8.7 (QH)
unnamed: J5.1, R48.2
unnamed: R48.1, U8.13 (*OE)
unnamed: R49.1, U8.10 (*SRCLR)
OSR0: J4.7, U8.5 (QF)
OSR1: J4.8, U8.6 (QG)
RESET: J4.6, U8.4 (QE)
SCLK: U8.11 (SRCLK)
XTR_DIS: J4.2, U8.15 (QA)

Notes on the sheet:
Short to enable SR
