arizzoni/baseboard/hardware/sim/peripheral-switches/sim.kicad_pcb

## KiCad design programmable gain.kicad_sch

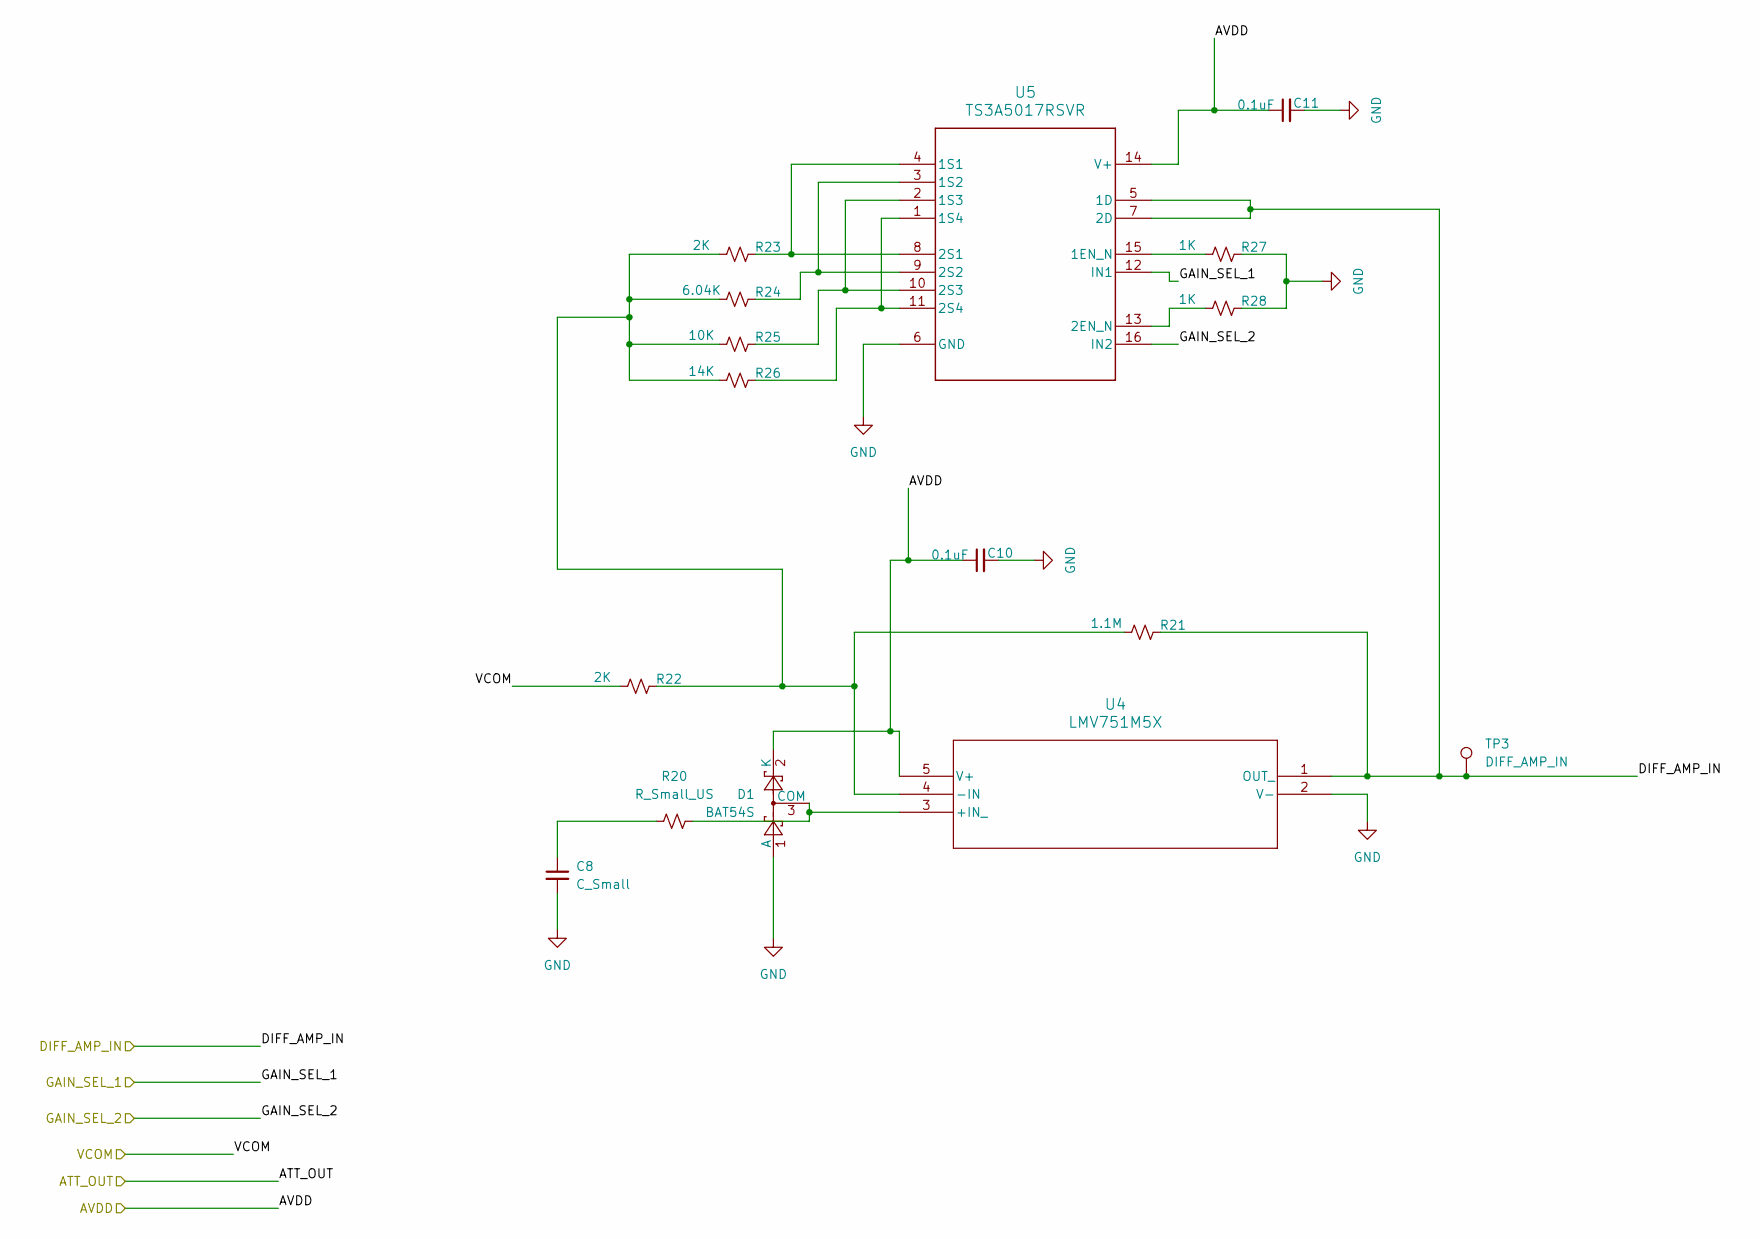
[picture p23: schematic programmable gain.kicad_sch]

Parts:
C8: C_Small
C10, C11: 0.1uF
D1: BAT54S; SOT-23
R20: R_Small_US
R21: 1.1M
R22, R23: 2K
R24: 6.04K
R25: 10K
R26: 14K
R27, R28: 1K
TP3: DIFF_AMP_IN
U4: LMV751M5X; MF05A_TEX
U5: TS3A5017RSVR; RSV0016A

Connections:
AVDD: C10.1, C11.1, D1.2 (K), U4.5 (V+), U5.14 (V+)
DIFF_AMP_IN: R21.2, TP3.1, U4.1 (OUT_), U5.5 (1D), U5.7 (2D)
GAIN_SEL_1: U5.12 (IN1)
GAIN_SEL_2: U5.16 (IN2)
GND: C8.2, C10.2, C11.2, D1.1 (A), R27.2, R28.2, U4.2 (V-), U5.6 (GND)
unnamed: C8.1, R20.1
unnamed: D1.3 (COM), R20.2, U4.3 (+IN_)
unnamed: R21.1, R22.2, R23.1, R24.1, R25.1, R26.1, U4.4 (-IN)
unnamed: R23.2, U5.4 (1S1), U5.8 (2S1)
unnamed: R24.2, U5.3 (1S2), U5.9 (2S2)
unnamed: R25.2, U5.2 (1S3), U5.10 (2S3)
unnamed: R26.2, U5.1 (1S4), U5.11 (2S4)
unnamed: R27.1, U5.15 (1EN_N)
unnamed: R28.1, U5.13 (2EN_N)
VCOM: R22.1
