arizzoni/baseboard/hardware/sim/peripheral-switches/sim.kicad_pcb

## KiCad design vref generator.kicad_sch

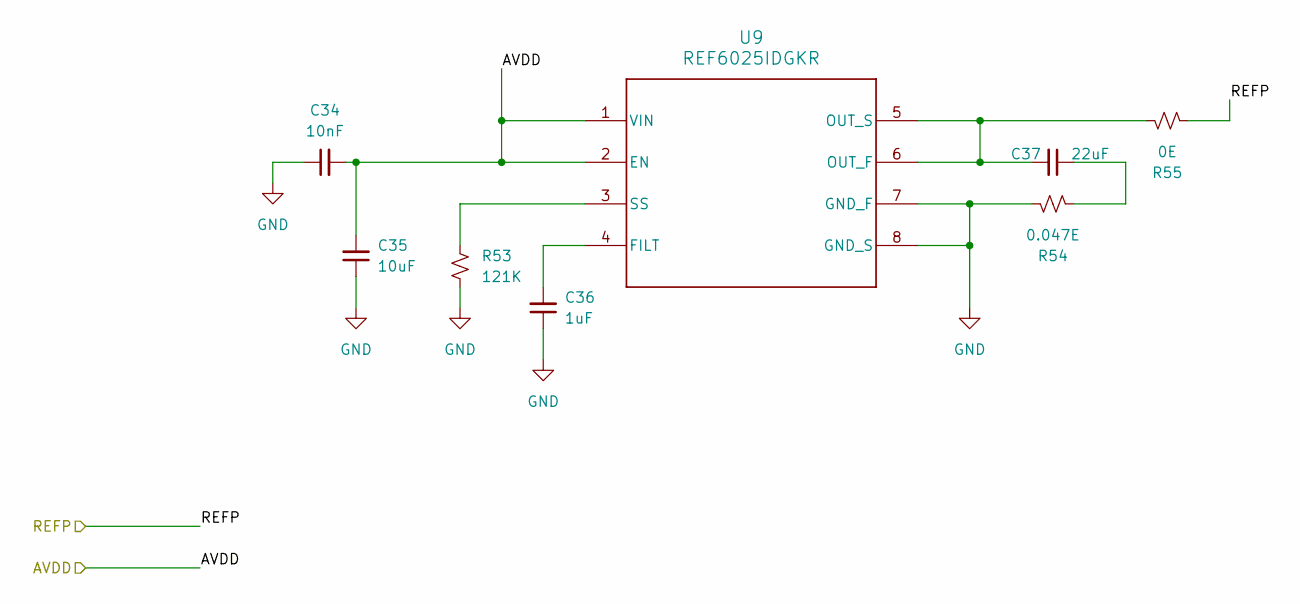
[picture p24: schematic vref generator.kicad_sch]

Parts:
C34: 10nF
C35: 10uF
C36: 1uF
C37: 22uF
R53: 121K
R54: 0.047E
R55: 0E
U9: REF6025IDGKR; DGK0008A_N

Connections:
AVDD: C34.2, C35.2, U9.1 (VIN), U9.2 (EN)
GND: C34.1, C35.1, C36.1, R53.2, R54.1, U9.7 (GND_F), U9.8 (GND_S)
unnamed: C36.2, U9.4 (FILT)
unnamed: C37.1, R54.2
unnamed: C37.2, R55.1, U9.5 (OUT_S), U9.6 (OUT_F)
unnamed: R53.1, U9.3 (SS)
REFP: R55.2
