arizzoni/baseboard/(commit log)

2023-05-06 uploaded project files
    initial commit
    [1590N1 IO Board.kicad_pcb, 1590N1 IO Board.kicad_sch, footswitches.kicad_sch, input_output.kicad_sch, mechanical.kicad_sch, microcontroller.kicad_sch, power.kicad_sch, switching.kicad_sch]
2023-05-09 added microcontroller enable to analog power rails
    [1590N1 IO Board.kicad_sch, footswitches.kicad_sch, input_output.kicad_sch, mechanical.kicad_sch, microcontroller.kicad_sch, power.kicad_sch, switching.kicad_sch]
2023-05-10 added reset button to microcontroller
    [1590N1 IO Board.kicad_sch, footswitches.kicad_sch, input_output.kicad_sch, microcontroller.kicad_sch, power.kicad_sch]
2023-05-11 swapped micro and started layout
    [1590N1 IO Board.kicad_pcb, input_output.kicad_sch, microcontroller.kicad_sch, power.kicad_sch]
2023-05-11 picked a third micro for extra pins, updated drd and refdoc.mplstyle
    [microcontroller.kicad_sch]
2023-05-11 placed components and finished new micro hw
    [1590N1 IO Board.kicad_pcb, footswitches.kicad_sch, microcontroller.kicad_sch, power.kicad_sch]
2023-05-13 swapped relays for nice analog switch, saved $4
    [1590N1 IO Board.kicad_sch, input_output.kicad_sch, mechanical.kicad_sch, microcontroller.kicad_sch, power.kicad_sch]
2023-05-13 updated schematic page setup
    [1590N1 IO Board.kicad_pcb, 1590N1 IO Board.kicad_sch, footswitches.kicad_sch, input_output.kicad_sch, io.kicad_sch, mechanical.kicad_sch, microcontroller.kicad_sch, peripherals.kicad_sch]
2023-05-13 more schematic cleanup
    [peripherals.kicad_sch]
2023-05-13 restarted layout
    [1590N1 IO Board.kicad_pcb]
2023-05-18 more early layout work
    [1590N1 IO Board.kicad_pcb, microcontroller.kicad_sch, power.kicad_sch]
2023-05-19 finished initial layout
    [1590N1 IO Board.kicad_pcb, microcontroller.kicad_sch, peripherals.kicad_sch, power.kicad_sch]
2023-05-19 drawing sheet updates and general prep for fab
    [peripherals.kicad_sch]
2023-05-21 cleaning up layout, added graphic symbols
    [io.kicad_sch, microcontroller.kicad_sch, peripherals.kicad_sch, power.kicad_sch]
2023-05-22 more layout cleanup, reorganized file directories
    [1590N1 IO Board.kicad_sch, io.kicad_sch, microcontroller.kicad_sch, peripherals.kicad_sch, power.kicad_sch]
2023-06-01 added differential inputs and started new layout
    [1590N1 IO Board.kicad_sch, io.kicad_sch, microcontroller.kicad_sch, peripherals.kicad_sch, power.kicad_sch]
2023-06-02 more layout updates
    [1590N1 IO Board.kicad_pcb, 1590N1 IO Board.kicad_sch, io.kicad_sch, microcontroller.kicad_sch, peripherals.kicad_sch, power.kicad_sch]
2023-07-21 reorganized project
    [1590N1 IO Board.kicad_pcb, 1590N1 IO Board.kicad_sch, audio.kicad_sch, baseboard.kicad_pcb, baseboard.kicad_sch, io.kicad_sch, microcontroller.kicad_sch, peripherals.kicad_sch]
2023-07-24 finalized schematic
    [audio.kicad_sch, baseboard.csv, baseboard.kicad_pcb, baseboard.kicad_sch, microcontroller.kicad_sch, power.kicad_sch]
2023-07-31 board layout first pass
    [audio.kicad_sch, baseboard.kicad_pcb, microcontroller.kicad_sch, power.kicad_sch]
2023-08-23 an inappropriately large commit
    [audio.kicad_sch, baseboard-B_Silkscreen.dxf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]
2023-09-01 released schematic
    [audio.kicad_sch, microcontroller.kicad_sch, power.kicad_sch]
2023-09-21 final tweaks pt. 1
    [baseboard.kicad_pcb]
2023-10-15 finalization before first board spin
    [baseboard-B_Cu (Ground).gbr, baseboard-B_Mask.gbr, baseboard-B_Paste.gbr, baseboard-B_Silkscreen.gbr, baseboard-Edge_Cuts.gbr, baseboard-F_Cu (Signal).gbr, baseboard-F_Mask.gbr, baseboard-F_Paste.gbr]
2024-02-11 started documentation
    [audio.kicad_sch, baseboard.kicad_pcb, baseboard.kicad_sch, microcontroller.kicad_sch, power.kicad_sch]
2024-02-27 minor changes before moving to new power supply topology
    [audio.kicad_sch, baseboard.kicad_sch, interface.kicad_sch, microcontroller.kicad_sch, power.kicad_sch, untitled.kicad_sch]
2024-03-29 started modeling circuits
    [audio.kicad_sch, baseboard.kicad_sch, microcontroller.kicad_sch, power.kicad_sch, sim.kicad_pcb, sim.kicad_sch]
